Strooom/LoRa-V3-PCB/README.md

# LoRa-V3 PCB




KiCAD design files for the LoRa-V3-PCB.

## Renders
## Front
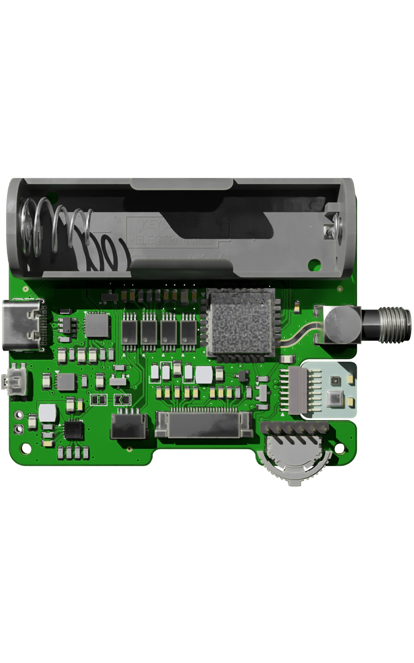
[picture p1: outputs/pcb/front.png]


## Back
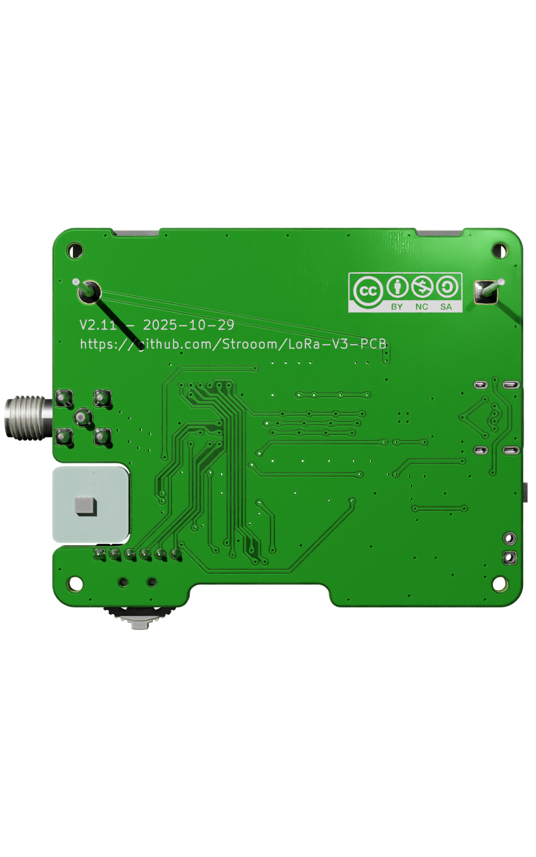
[picture p2: outputs/pcb/back.png]
