Strooom/LoRa-V3-PCB/outputs/reports/PCB design-rule-check report.html

Logo

| DRC report for LoRa-V3-PCB
| PCB: LoRa-V3-PCB Revision: None Date: 2025-10-29T14:37:27+0000 KiCad Version: 8.0.8 | Errors: 0 Warnings: 0 Total: 0

✔

Generated by KiBot (https://github.com/INTI-CMNB/KiBot/) v1.8.5
