Strooom/LoRa-V3-PCB/outputs/reports/schematic electrical-rule-check report.html

Logo

| ERC report for LoRa-V3-PCB
| Schematic: LoRa-V3-PCB Revision: v3.0 Date: 2025-10-29T14:37:25+0000 KiCad Version: 8.0.8 | Errors: 0 Warnings: 0 Total: 0

✔

Generated by KiBot (https://github.com/INTI-CMNB/KiBot/) v1.8.5
