Strooom/LoRa-V3-PCB/inputs/certification/114993121-CE.pdf

# VERIFICATION OF CONFORMITY

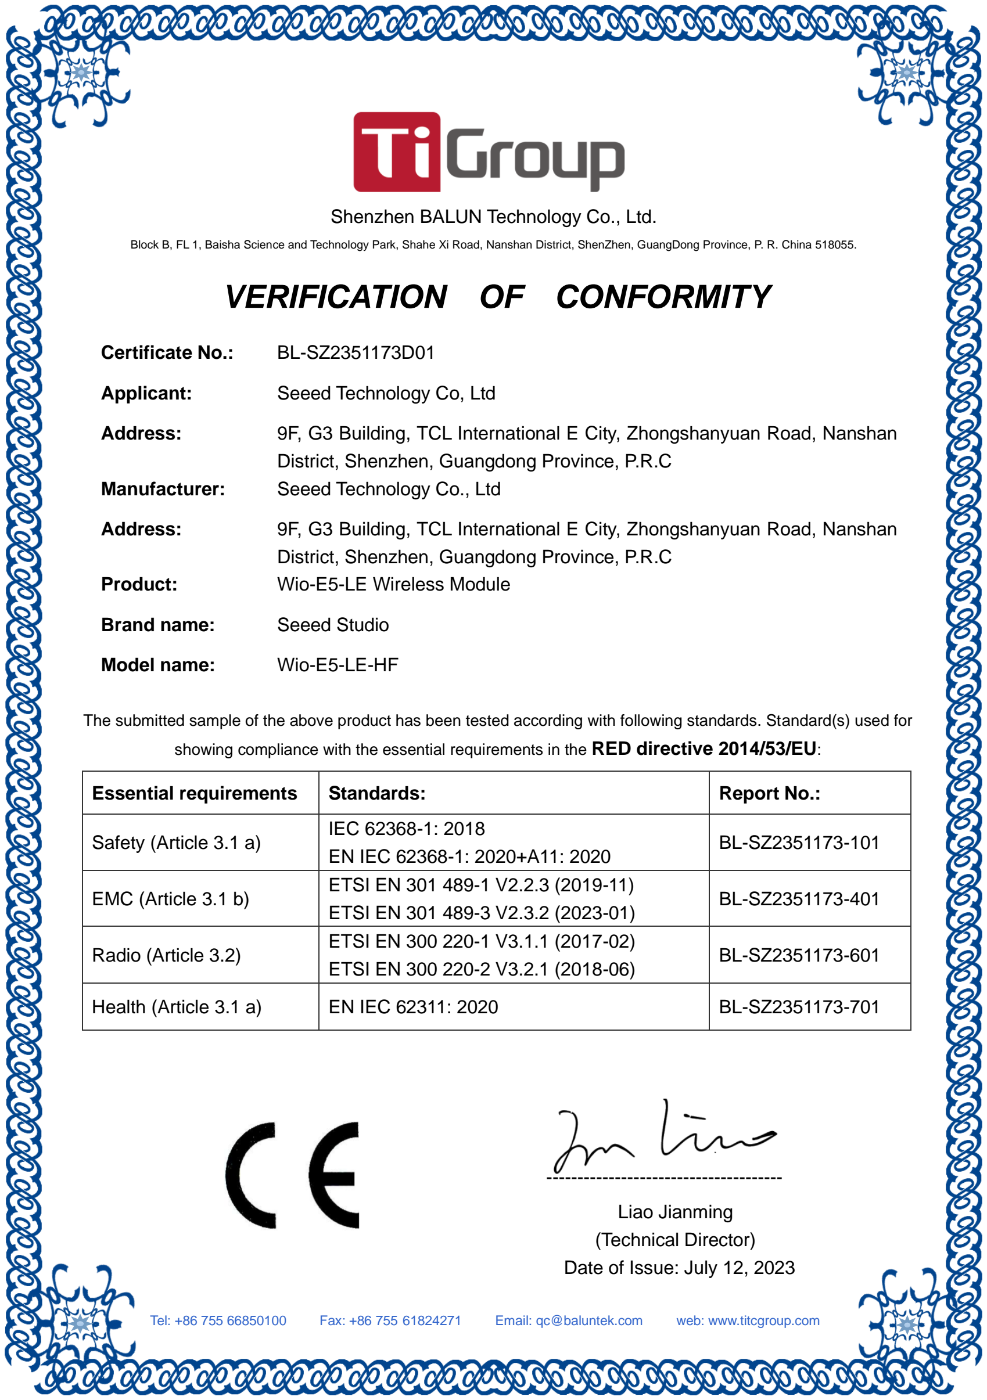
[picture p3: page 1]

Certificate No.: | BL-SZ2351173D01
Applicant: | Seeed Technology Co, Ltd
Address: | 9F, G3 Building, TCL International E City, Zhongshanyuan Road, Nanshan
| District, Shenzhen, Guangdong Province, P.R.C
Manufacturer: | Seeed Technology Co., Ltd
Address: | 9F, G3 Building, TCL International E City, Zhongshanyuan Road, Nanshan
| District, Shenzhen, Guangdong Province, P.R.C
Product: | Wio-E5-LE Wireless Module
Brand name: | Seeed Studio
Model name: | Wio-E5-LE-HF
Essential requirements | Standards: | Report No.:
Safety (Article 3.1 a) | IEC 62368-1: 2018 EN IEC 62368-1: 2020+A11: 2020 | BL-SZ2351173-101
EMC (Article 3.1 b) | ETSI EN 301 489-1 V2.2.3 (2019-11) ETSI EN 301 489-3 V2.3.2 (2023-01) | BL-SZ2351173-401
Radio (Article 3.2) | ETSI EN 300 220-1 V3.1.1 (2017-02) ETSI EN 300 220-2 V3.2.1 (2018-06) | BL-SZ2351173-601
Health (Article 3.1 a) | EN IEC 62311: 2020 | BL-SZ2351173-701

Shenzhen BALUN Technology Co., Ltd.

Block B, FL 1, Baisha Science and Technology Park, Shahe Xi Road, Nanshan District, ShenZhen, GuangDong Province, P. R. China 518055.

The submitted sample of the above product has been tested according with following standards. Standard(s) used for

showing compliance with the essential requirements in the RED directive 2014/53/EU:

Tel: +86 755 66850100 | Fax: +86 755 61824271 | Email: qc@baluntek.com | web: www.titcgroup.com

Liao Jianming
(Technical Director)
Date of Issue: July 12, 2023
