Strooom/LoRa-V3-PCB/inputs/certification/114993121-EUDOC.pdf

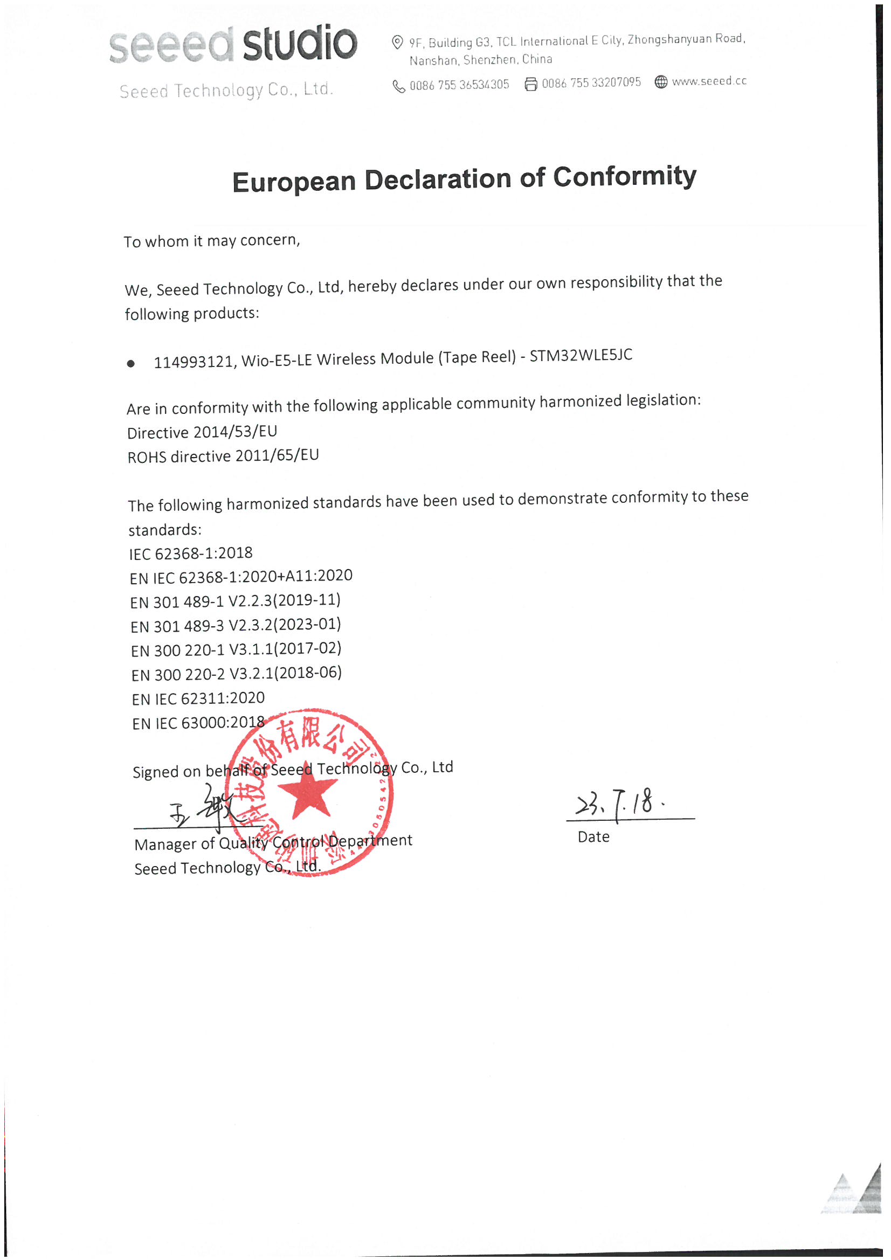
[picture p4: page 1]
