Strooom/LoRa-V3-PCB/inputs/certification/114993121-UKDOC.pdf

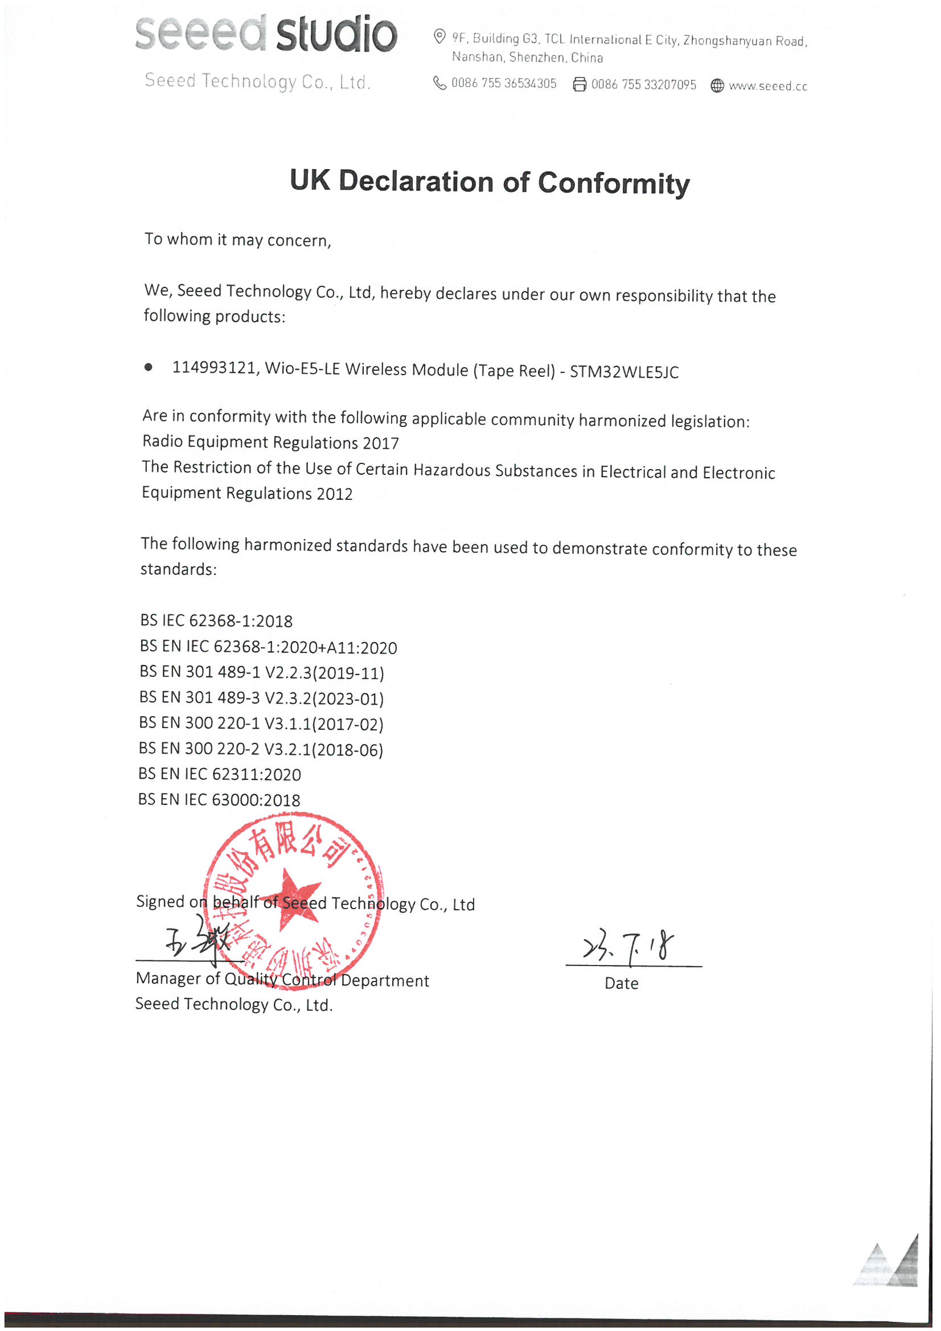
[picture p5: page 1]
