Strooom/LoRa-V3-PCB/outputs/bom/LoRa-V3-PCB-bom.html

 | KiBot Bill of Materials
 | Schematic: LoRa-V3-PCB Variant: default Revision: v3.0 Date: 2024-08-09 KiCad Version: 8.0.8+1 | Component Groups: 35 Component Count: 73 (per PCB) Fitted Components: 73 (per PCB) Number of PCBs: 1 Total Components: 73 (for 1 PCBs)
References | Part | Value | Quantity Per PCB | manufacturerName | manufacturerPartNumber | octopartUrl
C1 C2 C5 C6 C7 C8 C9 C10 | C | 100nF | 8 | TDK | CGA3E2X7R1E104K080AA | https://octopart.com/cga3e2x7r1e104k080aa-tdk-25947977?r=sp
C30 C31 C32 C33 C34 C35 C36 C37 | C_Small | 1uF | 8 | TDK | CGA3E1X7R1E105K080AC | https://octopart.com/cga3e1x7r1e105k080ac-tdk-25947974?r=sp
C11 C12 C13 C14 C15 C16 C17 C18 | C | 4.7uF | 8 | Samsung Electro-Mechanics | CL21B475KPFNFNE | https://octopart.com/cl21b475kpfnfne-samsung+electro-mechanics-24958210
C25 C26 C27 | C | 10uF | 3 | Samsung Electro-Mechanics | CL21B106KPQNNWE | https://octopart.com/cl21b106kpqnnwe-samsung+electro-mechanics-52884428
CONN6 | displayConnector_24p_FPC | 2-1734839-4 | 1 | TE Connectivity | 2-1734839-4 | https://octopart.com/2-1734839-4-te+connectivity-40196932?r=sp
CONN1 | Molex-2171790001 | 217179-0001 | 1 | Molex | 217179-0001 | https://octopart.com/217179-0001-molex-117190526?r=sp
CONN5 | SMA-Antenna-Connector-THT-90 | 73391-0080 | 1 | Molex | 73391-0080 | https://octopart.com/73391-0080-molex-776539?r=sp&pdp=73391-0080-molex-776539¤cy=EUR
CONN2 | LiFePO4_Battery | AA Batteryholder for LiFePO4 battery | 1 | KeyStone | 2460 | https://octopart.com/2460-keystone-17876
CONN3 | Qwiic | SM04B-SRSS-TB(LF)(DN)(P) | 1 | Sparkfun - JST | SM04B-SRSS-TB(LF)(DN)(P) | https://octopart.com/sm04b-srss-tb%28lf%29%28dn%29%28p%29-jst-154671066?r=sp
CONN7 | Conn_01x08_Sensors | Sensors | 1 | GCT | BC075-08-A-L-A
D1 D2 D3 | D | MSS1P3HM3_A/H | 3 | MSS1P3HM3_A/H | MSS1P3HM3_A/H | https://octopart.com/mss1p3hm3_a%2Fh-vishay-71706624?r=sp
IC4 | BQ25504RGTR | BQ25504RGTR | 1 | Texas Instruments | BQ25504RGTR | https://octopart.com/bq25504rgtr-texas+instruments-20530455
IC8 IC9 IC10 IC11 | BR24G1MFVT | BR24G1MFVT-5AE2 | 4 | ROHM | BR24G1MFVT-5AE2 | https://octopart.com/br24g1mfvt-5ae2-rohm-126430213
IC2 | CP2102N-Axx-xQFN24 | CP2102N-Axx-xQFN24 | 1 | Silicon Labs | CP2102N-A02-GQFN24R | https://octopart.com/cp2102n-a02-gqfn24r-silicon+labs-99772192?r=sp
IC12 | MCP73123T | MCP73123T-22SI/MF | 1 | MICROCHIP | MCP73123T-22SI/MF | https://octopart.com/mcp73123t-22si%2Fmf-microchip-17627238?r=sp
IC1 | SeeedStudio_Wio-E5 | SeeedStudio Wio-E5-LE-HF | 1 | Seeed Technology | 114993121 | https://octopart.com/114993121-seeed+studio-142683940
IC3 | USBLC6-2SC6 | USBLC6-2SC6 | 1 | STMicroelectronics | USBLC6-2SC6 | https://octopart.com/usblc6-2sc6-stmicroelectronics-39666276
L2 | L | 22 uH | 1 | TDK | VLS3010CX-220M-1 | https://octopart.com/vls3010cx-220m-1-tdk-108018957?r=sp
L1 | L | 47uH | 1 | TDK | VLS3010CX-470M-1 | https://octopart.com/vls3010cx-470m-1-tdk-110194027?r=sp
Q1 | Q_NMOS_GSD | PJC7400_R1_00001 | 1 | Panjit | PJC7400_R1_00001 | https://octopart.com/pjc7400_r1_00001-panjit-112852220?r=sp
Q2 Q3 Q4 | Si2367DS | Si2367DS | 3 | Vishay Siliconix | SI2367DS-T1-GE3 | https://octopart.com/si2367ds-t1-ge3-vishay-42637886?r=sp
R23 | R | 330 | 1 | YAGEO | RC0603FR-7W330RL | https://octopart.com/rc0603fr-7w330rl-yageo-52751815
R3 | R | 1K | 1 | YAGEO | SR0603JR-071KL | https://octopart.com/sr0603jr-071kl-yageo-71414179
R5 R6 R7 R8 R9 R10 | R | 5K1 | 6 | YAGEO | AC0603DR-075K1L | https://octopart.com/ac0603dr-075k1l-yageo-100620021
R12 | R | 10K | 1 | Bourns | CR0603-JW-103ELF | https://octopart.com/cr0603-fx-1002elf-bourns-2326648?r=sp
R13 | R | 22K1 | 1 | YAGEO | AC0603FR-0722K1L | https://octopart.com/ac0603fr-0722k1l-yageo-30510747
R15 | R | 47K5 | 1 | YAGEO | AC0603FR-0747K5L | https://octopart.com/ac0603fr-0747k5l-yageo-71367307
R17 R18 | R | 330K | 2 | YAGEO | AC0603JR-07330KL | https://octopart.com/ac0603jr-07330kl-yageo-30510863
R2 | R | 1M69 | 1 | YAGEO | RC0603FR-071M69L | https://octopart.com/rc0603fr-071m69l-yageo-16255598
R14 R20 | R | 4M75 | 2 | YAGEO | RC0603FR-074M75L | https://octopart.com/rc0603fr-074m75l-yageo-1187229
R11 R21 | R | 5M36 | 2 | Vishay - Dale | CRCW06035M36FKEA | https://octopart.com/crcw06035m36fkea-vishay-39816157
R19 | R | 8M45 | 1 | YAGEO | RC0603FR-078M45L | https://octopart.com/rc0603fr-078m45l-yageo-26128888
R1 | R | ERJ-3RQJ2R2V | 1 | Panasonic | ERJ-3RQJ2R2V | https://octopart.com/erj3rqj2r2v-panasonic-8095978?r=sp
SW1 | Switch_434331045822 | 434331045822 | 1 | Wurth Electronics | 434331045822 | https://octopart.com/434331045822-wurth+elektronik-22866031?r=sp
SW2 | SLLB510100 | SLLB510100 | 1 | Alps Alpine | SLLB510100 | https://octopart.com/sllb510100-alps-1050713?r=sp
Color reference for columns:
KiCad Fields (default)
Generated Fields
User Fields
Empty Fields
