Strooom/LoRa-V3-PCB/outputs/bom/kicost-bom.xlsx

Prj: | kicost-bom.csv |  |  |  | Board Qty: | 100
Co.: |  |  |  |  | Unit Cost: | €39.49
Prj date: | 2025-03-11 14:44:24 (file) |  |  |  | Total Cost: | €3949.10 |  |  |  |  | €3949.10 | 36 of 37 parts found
$ date: | 2025-03-12 16:26:13
Global Part Info |  |  |  |  |  |  | Mouser
Refs | Value | Footprint | Manf# | Qty | Unit$ | Ext$ | Avail | Purch | Unit$ | MOQ | Ext$ | Cat#
C1-C10 | ??? | ??? | CGA3E2X7R1E104K080AA | 1000 | €0.014 | €14.00 | 928170 |  | €0.014 | 1 | €14.00 | 810-CGA3E2X7R1E104K (https://www.mouser.be/ProductDetail/TDK/CGA3E2X7R1E104K080AA?qs=NRhsANhppD%2Fm7%2FOmmsm0vg%3D%3D)
C11-C18 | ??? | ??? | CL21B475KPFNFNE (https://www.mouser.com/datasheet/2/585/MLCC-1837944.pdf) | 800 | €0.105 | €84.00 | 16674 |  | €0.105 | 1 | €84.00 | 187-CL21B475KPFNFNE (https://www.mouser.be/ProductDetail/Samsung-Electro-Mechanics/CL21B475KPFNFNE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)
C25-C27 | ??? | ??? | CL21B106KPQNNWE (https://www.mouser.com/datasheet/2/585/MLCC-1837944.pdf) | 300 | €0.067 | €20.10 | 260322 |  | €0.067 | 1 | €20.10 | 187-CL21B106KPQNNWE (https://www.mouser.be/ProductDetail/Samsung-Electro-Mechanics/CL21B106KPQNNWE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)
C30-C37 | ??? | ??? | CGA3E1X7R1E105K080AC | 800 | €0.049 | €39.20 | 148338 |  | €0.049 | 1 | €39.20 | 810-CGA3E1X7R1E105K (https://www.mouser.be/ProductDetail/TDK/CGA3E1X7R1E105K080AC?qs=NRhsANhppD9VxGl2AsmRpw%3D%3D)
CONN1 | ??? | ??? | 217179-0001 | 100 | €0.487 | €48.70 | 25716 |  | €0.487 | 1 | €48.70 | 538-217179-0001 (https://www.mouser.be/ProductDetail/Molex/217179-0001?qs=DRkmTr78QAQqCH4BoIR1xg%3D%3D)
CONN2 | ??? | ??? | 1015 (https://www.mouser.com/datasheet/2/215/1015-744831.pdf) | 100 | €1.990 | €199.00 | 21079 |  | €1.990 | 1 | €199.00 | 534-1015 (https://www.mouser.be/ProductDetail/Keystone-Electronics/1015?qs=73q%2FgRcW4F2OhJTPPQWZpA%3D%3D)
CONN3 | ??? | ??? | SM04B-SRSS-TB(LF)(DN)(P) (https://www.mouser.com/datasheet/2/564/eSH-3450197.pdf) | 100 |  |  | NonStk |  |  |  |  | 306-SM04BSRSSTBLFDNP (https://www.mouser.be/ProductDetail/JST-Automotive/SM04B-SRSS-TBLFDNP?qs=HFfMDpzxxd2NueaCTHhRJg%3D%3D)
CONN5 | ??? | ??? | 73391-0080 | 100 | €2.750 | €275.00 | 891 |  | €2.750 | 1 | €275.00 | 538-73391-0080 (https://www.mouser.be/ProductDetail/Molex/73391-0080?qs=Vtbn2VVmZzHv%2FRqBuG7a1A%3D%3D)
CONN6 | ??? | ??? | 2-1734839-4 (https://www.mouser.com/datasheet/2/418/7/ENG_CD_1734839_C_C_1734839-2017341.pdf) | 100 | €0.642 | €64.20 | 133 |  | €0.642 | 1 | €64.20 | 571-2-1734839-4 (https://www.mouser.be/ProductDetail/TE-Connectivity/2-1734839-4?qs=Sm6ibA7evxgHWeCe9t1tOw%3D%3D)
D1-D3 | ??? | ??? | MSS1P3HM3_A/H | 300 | €0.108 | €32.40 | 65583 |  | €0.108 | 1 | €32.40 | 78-MSS1P3HM3_A/H (https://www.mouser.be/ProductDetail/Vishay-General-Semiconductor/MSS1P3HM3_A-H?qs=Pccw3SRxl2RHPUJ7xw8Tvg%3D%3D)
IC1 | ??? | ??? | 114993121 (https://www.mouser.com/datasheet/2/744/Wio_E5_LE_module_datasheet_v1_0-3446934.pdf) | 100 | €7.640 | €764.00 | 96 |  | €7.640 | 1 | €764.00 | 713-114993121 (https://www.mouser.be/ProductDetail/Seeed-Studio/114993121?qs=QpmGXVUTftF1SD6oRXq2Mw%3D%3D)
IC2 | ??? | ??? | CP2102N-A02-GQFN24R (https://www.mouser.com/datasheet/2/368/cp2102n_datasheet-1634912.pdf) | 100 | €2.720 | €272.00 | 12283 |  | €2.720 | 1 | €272.00 | 634-CP2102NA02QFN24R (https://www.mouser.be/ProductDetail/Silicon-Labs/CP2102N-A02-GQFN24R?qs=u16ybLDytRaIVBf0X4zL0g%3D%3D)
IC3 | ??? | ??? | USBLC6-2P6 (https://www.mouser.com/datasheet/2/389/usblc6_2-1852789.pdf) | 100 | €0.192 | €19.20 | 55399 |  | €0.192 | 1 | €19.20 | 511-USBLC6-2P6 (https://www.mouser.be/ProductDetail/STMicroelectronics/USBLC6-2P6?qs=6ARB0lp6jlViGcbUSvj1Mw%3D%3D)
IC4 | ??? | ??? | BQ25504RGTR | 100 | €2.620 | €262.00 | 3093 |  | €2.620 | 1 | €262.00 | 595-BQ25504RGTR (https://www.mouser.be/ProductDetail/Texas-Instruments/BQ25504RGTR?qs=LDM2r2BBpna1ocxRvQkZ2w%3D%3D)
IC5 | ??? | ??? | BME680 (https://www.mouser.com/datasheet/2/783/BST_BME680_DS001-1509608.pdf) | 100 | €5.740 | €574.00 | 8984 |  | €5.740 | 1 | €574.00 | 262-BME680 (https://www.mouser.be/ProductDetail/Bosch-Sensortec/BME680?qs=v271MhAjFHjo0yA%2FC4OnDQ%3D%3D)
IC6 | ??? | ??? | SHT40-BD1B-R2 (https://www.mouser.com/datasheet/2/682/HT_DS_Datasheet_SHT4x_3-2936319.pdf) | 100 | €1.160 | €116.00 | 3188 |  | €1.160 | 1 | €116.00 | 403-SHT40-BD1B-R2 (https://www.mouser.be/ProductDetail/Sensirion/SHT40-BD1B-R2?qs=ulEaXIWI0c%252BjgdkzNQkrGw%3D%3D)
IC7 | ??? | ??? | TSL25911FN (https://www.mouser.com/datasheet/2/588/asset_pdf_25493382-3432823.pdf) | 100 | €1.420 | €142.00 | 8371 |  | €1.420 | 1 | €142.00 | 985-TSL25911FN (https://www.mouser.be/ProductDetail/ams-OSRAM/TSL25911FN?qs=6irNfxKJ9AaiNMbaQmyIug%3D%3D)
IC8-IC11 | ??? | ??? | BR24G1MFVT-5AE2 | 400 | €1.170 | €468.00 | 3347 |  | €1.170 | 1 | €468.00 | 755-BR24G1MFVT-5AE2 (https://www.mouser.be/ProductDetail/ROHM-Semiconductor/BR24G1MFVT-5AE2?qs=MyNHzdoqoQKnzx5taP2O%252BA%3D%3D)
IC12 | ??? | ??? | MCP73123T-22SI/MF (https://www.mouser.com/datasheet/2/268/22191E-3443442.pdf) | 100 | €1.080 | €108.00 | 1245 |  | €1.080 | 1 | €108.00 | 579-MCP73123T-22SIMF (https://www.mouser.be/ProductDetail/Microchip-Technology/MCP73123T-22SI-MF?qs=E6wAi2XWqcPyISItqwXTaQ%3D%3D)
L1 | ??? | ??? | VLS3010CX-470M-1 | 100 | €0.112 | €11.20 | 3674 |  | €0.112 | 1 | €11.20 | 810-VLS3010CX470M1 (https://www.mouser.be/ProductDetail/TDK/VLS3010CX-470M-1?qs=sPbYRqrBIVklbjNBYl28FA%3D%3D)
L2 | ??? | ??? | VLS3010CX-220M-1 | 100 | €0.150 | €15.00 | 2404 |  | €0.150 | 1 | €15.00 | 810-VLS3010CX220M1 (https://www.mouser.be/ProductDetail/TDK/VLS3010CX-220M-1?qs=sPbYRqrBIVnZdOaBHPV0MQ%3D%3D)
Q1 | ??? | ??? | PJC7400_R1_00001 (https://www.mouser.com/datasheet/2/1057/PJC7400-1868968.pdf) | 100 | €0.072 | €7.20 | 34967 |  | €0.072 | 1 | €7.20 | 241-PJC7400_R1_00001 (https://www.mouser.be/ProductDetail/Panjit/PJC7400_R1_00001?qs=sPbYRqrBIVlqNtfR5hXF4A%3D%3D)
Q2-Q4 | ??? | ??? | SI2367DS-T1-GE3 | 300 | €0.245 | €73.50 | 5668 |  | €0.245 | 1 | €73.50 | 781-SI2367DS-GE3 (https://www.mouser.be/ProductDetail/Vishay-Semiconductors/SI2367DS-T1-GE3?qs=kt16UJ73eEHbeglRjuryig%3D%3D)
R1 | ??? | ??? | ERJ-3RQJ2R2V | 100 | €0.029 | €2.90 | 17203 |  | €0.029 | 1 | €2.90 | 667-ERJ-3RQJ2R2V (https://www.mouser.be/ProductDetail/Panasonic/ERJ-3RQJ2R2V?qs=Ytx7DkVehETJPMlDNlXENw%3D%3D)
R2 | ??? | ??? | RC0603FR-071M69L (https://www.mouser.com/datasheet/2/447/PYu_RC_Group_51_RoHS_L_12-3368608.pdf) | 100 | €0.009 | €0.90 | 174195 |  | €0.009 | 1 | €0.90 | 603-RC0603FR-071M69L (https://www.mouser.be/ProductDetail/YAGEO/RC0603FR-071M69L?qs=0yPvnVz5%2Fmqj6bp9FXiCew%3D%3D)
R3 | ??? | ??? | SR0603JR-071KL (https://www.mouser.com/datasheet/2/447/YAGEO_11022023_PYu_SR_20105_RoHS_L_11-3361774.pdf) | 100 | €0.038 | €3.80 | 150380 |  | €0.038 | 1 | €3.80 | 603-SR0603JR-071KL (https://www.mouser.be/ProductDetail/YAGEO/SR0603JR-071KL?qs=TyBUSTk9pD97MoKjQ9xH4g%3D%3D)
R5-R10 | ??? | ??? | AC0603DR-075K1L (https://www.mouser.com/datasheet/2/447/PYu_AC_51_RoHS_L_11-3418659.pdf) | 600 | €0.016 | €9.60 | 60096 |  | €0.016 | 1 | €9.60 | 603-AC0603DR-075K1L (https://www.mouser.be/ProductDetail/YAGEO/AC0603DR-075K1L?qs=fTsMJN6MUUuGibmKEEUTpQ%3D%3D)
R11,R21 | ??? | ??? | RC0603FR-075M36L (https://www.mouser.com/datasheet/2/447/PYu_RC_Group_51_RoHS_L_11-1984063.pdf) | 200 | €0.010 | €2.00 | NonStk |  | €0.010 | 1 | €2.00 | 603-RC0603FR-075M36L (https://www.mouser.be/ProductDetail/YAGEO/RC0603FR-075M36L?qs=EiqXWrxQq61wtU12vahNbg%3D%3D)
R12 | ??? | ??? | CR0603-JW-103ELF (https://www.mouser.com/datasheet/2/54/cr-1858361.pdf) | 100 | €0.007 | €0.70 | 457126 |  | €0.007 | 1 | €0.70 | 652-CR0603-JW-103ELF (https://www.mouser.be/ProductDetail/Bourns/CR0603-JW-103ELF?qs=tprK%2FdUq6q6vORSl%252Bpo4rg%3D%3D)
R13 | ??? | ??? | AC0603FR-0722K1L (https://www.mouser.com/datasheet/2/447/PYu_AC_51_RoHS_L_11-3418659.pdf) | 100 | €0.009 | €0.90 | 355233 |  | €0.009 | 1 | €0.90 | 603-AC0603FR-0722K1L (https://www.mouser.be/ProductDetail/YAGEO/AC0603FR-0722K1L?qs=ygRr%2FtkhtetDZXS2sa3i2w%3D%3D)
R14,R20 | ??? | ??? | RC0603FR-074M75L (https://www.mouser.com/datasheet/2/447/YAGEO_PYu_RC_Group_51_RoHS_L_12-3313492.pdf) | 200 | €0.007 | €1.40 | 44745 |  | €0.007 | 1 | €1.40 | 603-RC0603FR-074M75L (https://www.mouser.be/ProductDetail/YAGEO/RC0603FR-074M75L?qs=KuCtQF8z8nCEE2Ng4Op1ag%3D%3D)
R15 | ??? | ??? | AC0603FR-0747K5L (https://www.mouser.com/datasheet/2/447/PYu_AC_51_RoHS_L_11-3418659.pdf) | 100 | €0.009 | €0.90 | 19285 |  | €0.009 | 1 | €0.90 | 603-AC0603FR-0747K5L (https://www.mouser.be/ProductDetail/YAGEO/AC0603FR-0747K5L?qs=ygRr%2Ftkhtes%2F5uKM6MtQGw%3D%3D)
R17,R18 | ??? | ??? | AC0603JR-07330KL (https://www.mouser.com/datasheet/2/447/PYu_AC_51_RoHS_L_11-3418659.pdf) | 200 | €0.007 | €1.40 | 64642 |  | €0.007 | 1 | €1.40 | 603-AC0603JR-07330KL (https://www.mouser.be/ProductDetail/YAGEO/AC0603JR-07330KL?qs=ygRr%2FtkhteswRX2BvSPS%2Fg%3D%3D)
R19 | ??? | ??? | RC0603FR-078M45L (https://www.mouser.com/datasheet/2/447/PYu_RC_Group_51_RoHS_L_11-1984063.pdf) | 100 | €0.010 | €1.00 | 31341 |  | €0.010 | 1 | €1.00 | 603-RC0603FR-078M45L (https://www.mouser.be/ProductDetail/YAGEO/RC0603FR-078M45L?qs=EiqXWrxQq61D3M9nCx1jvA%3D%3D)
R23 | ??? | ??? | RC0603FR-7W330RL (https://www.mouser.com/datasheet/2/447/PYu_RC_Group_51_RoHS_L_12-3368608.pdf) | 100 | €0.013 | €1.30 | 31569 |  | €0.013 | 1 | €1.30 | 603-RC0603FR-7W330RL (https://www.mouser.be/ProductDetail/YAGEO/RC0603FR-7W330RL?qs=tggtontpCXPwS4JfrCYUrA%3D%3D)
SW1 | ??? | ??? | 434331045822 | 100 | €0.466 | €46.60 | 5561 |  | €0.466 | 1 | €46.60 | 710-434331045822 (https://www.mouser.be/ProductDetail/Wurth-Elektronik/434331045822?qs=wr8lucFkNMXGC%252BBo3q5pkg%3D%3D)
SW2 | ??? | ??? | SLLB510100 (https://www.mouser.com/datasheet/2/15/SLLB5-1570014.pdf) | 100 | €2.670 | €267.00 | 5078 |  | €2.670 | 1 | €267.00 | 688-SLLB510100 (https://www.mouser.be/ProductDetail/Alps-Alpine/SLLB510100?qs=m0BA540hBPceO6mn4aSKcg%3D%3D)
 |  |  |  |  | Total Purchase: | €0.00 | Buy here (https://mouser.com/bom/) |  |  |  | €0.00
KiCost® v1.1.19 |  |  |  |  | Purchase description:
