Strooom/LoRa-V3-PCB/inputs/3dmodels/2460.step

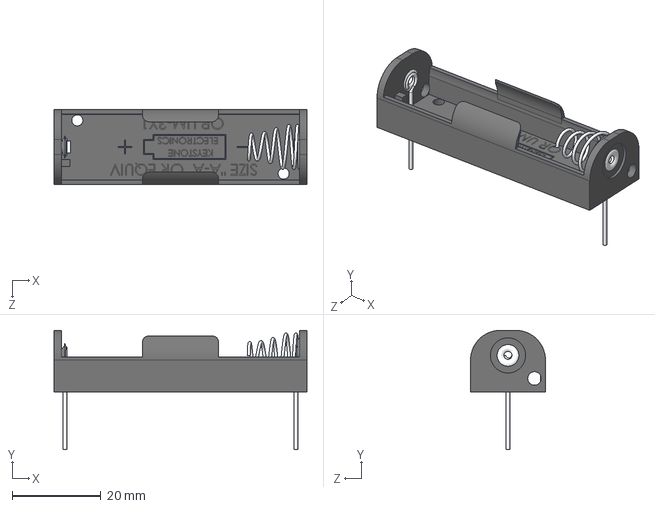
[picture p6: CAD file, 2025-08-07]
inputs/3dmodels/2460.step
57.0 x 26.9 x 16.9 mm
