Strooom/LoRa-V3-PCB/projectlibraries/1project3dmodels/1015.stp

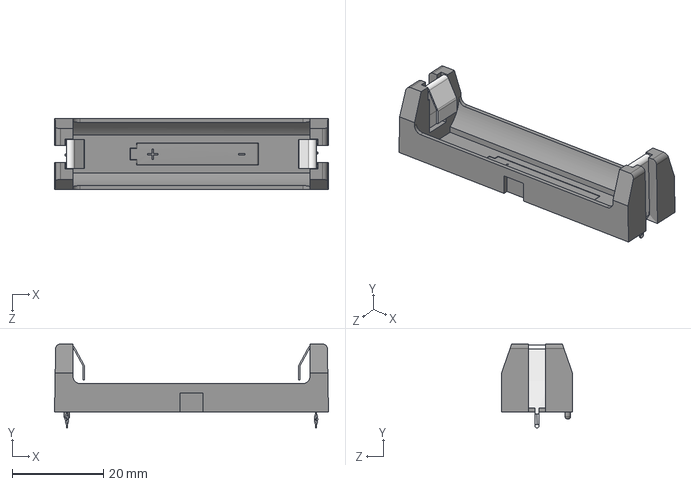
[picture p7: CAD file, 2024-09-23]
projectlibraries/1project3dmodels/1015.stp
59.9 x 18.3 x 15.5 mm
