Strooom/LoRa-V3-PCB/projectlibraries/inputs/DFN-8 2x3.step

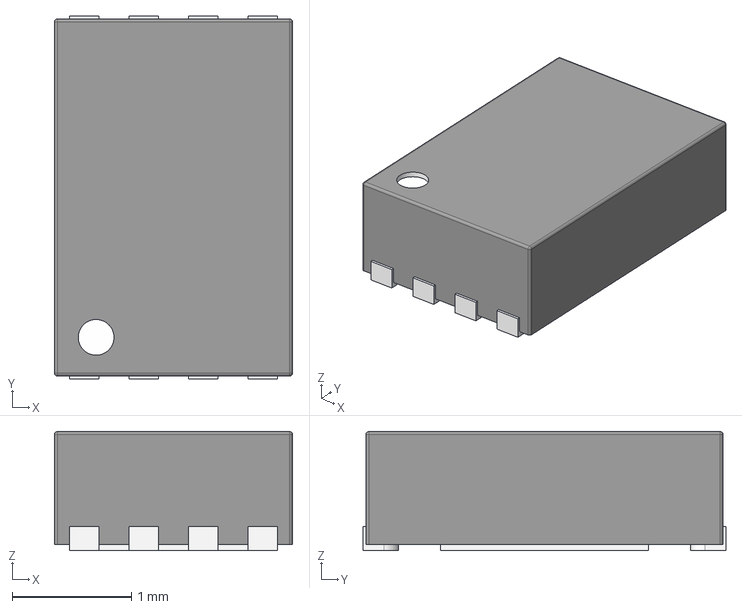
[picture p8: CAD file, 2024-09-23]
projectlibraries/inputs/DFN-8 2x3.step
2.00 x 3.05 x 1.00 mm
