Strooom/LoRa-V3-PCB/inputs/3dmodels/LoRa-V3-Sensor-PCB-3D.step

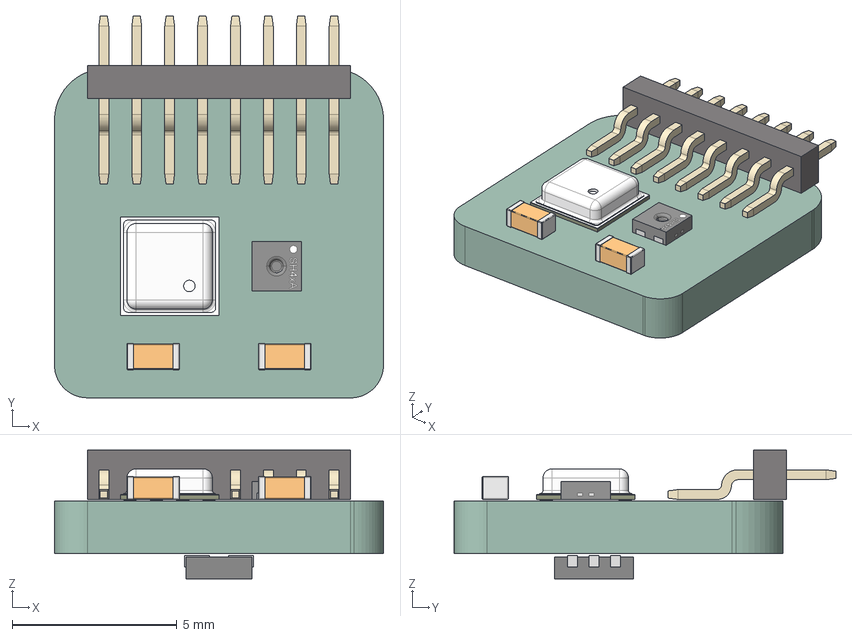
[picture p9: CAD file, 2025-04-23]
inputs/3dmodels/LoRa-V3-Sensor-PCB-3D.step
10.0 x 11.6 x 3.91 mm
BC034-08-A-V-0150-L-C
BME680
149048-00_Publikationsmodell SHT4xA-StandardDFN
LoRa-V3-Sensor-PCB_PCB
