Strooom/LoRa-V3-PCB/projectlibraries/1project3dmodels/PCB.SMAFRA.HT.stp

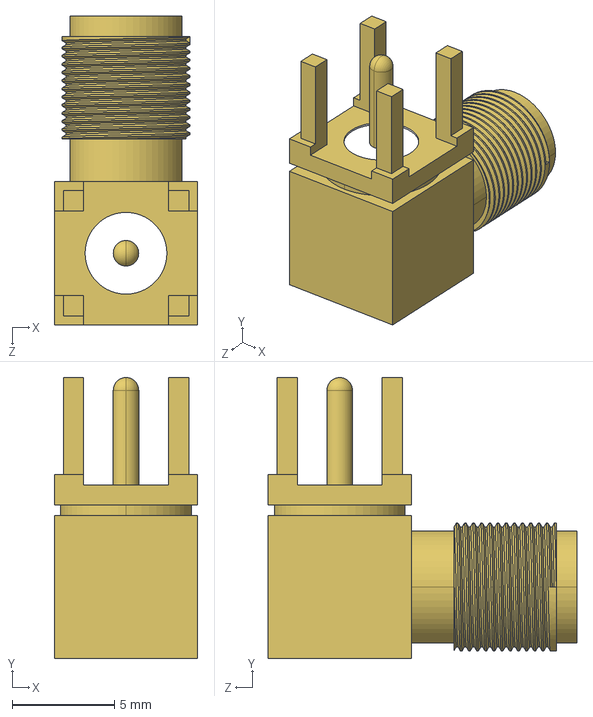
[picture p10: CAD file, 2024-09-23]
projectlibraries/1project3dmodels/PCB.SMAFRA.HT.stp
7.00 x 13.8 x 15.1 mm
