Strooom/LoRa-V3-PCB/projectlibraries/inputs/SDM05U40CSPQ-7.stp

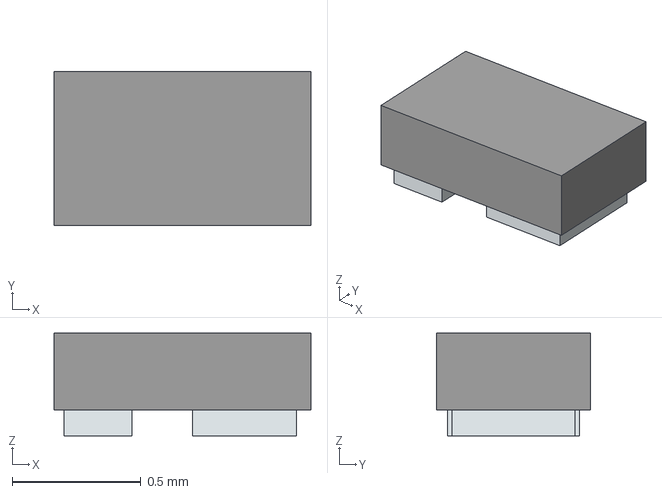
[picture p11: CAD file, 2024-09-23]
projectlibraries/inputs/SDM05U40CSPQ-7.stp
1.00 x 0.6 x 0.4 mm
Pins
