Strooom/LoRa-V3-PCB/inputs/3dmodels/BC075-08-A-L-A.stp

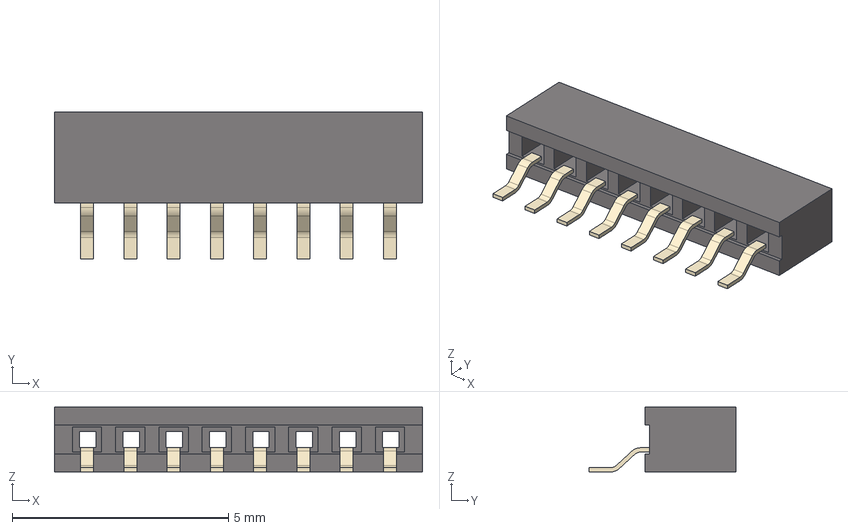
[picture p12: CAD file, 2025-04-16]
inputs/3dmodels/BC075-08-A-L-A.stp
8.50 x 3.40 x 1.50 mm
BC075-08-A-L-A_H
BC075-08-A-L-A_P x 8
