Strooom/LoRa-V3-PCB/projectlibraries/inputs/SPV1050-WST.stp

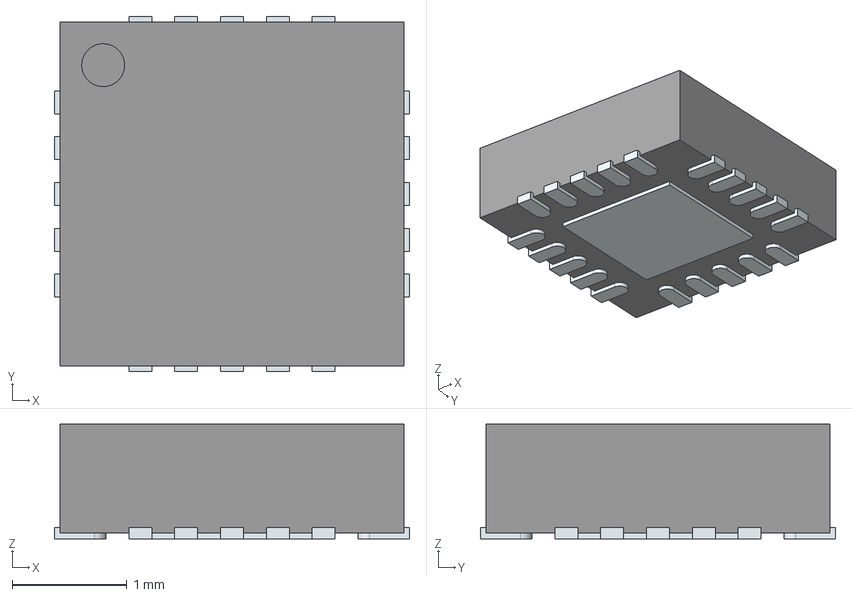
[picture p13: CAD file, 2024-09-23]
projectlibraries/inputs/SPV1050-WST.stp
3.10 x 3.10 x 1.00 mm
ThermalPin
PinsArrayLR
PinsArrayTB
