Strooom/LoRa-V3-PCB/inputs/3dmodels/BC034-04-A-V-0150-L-C.STEP

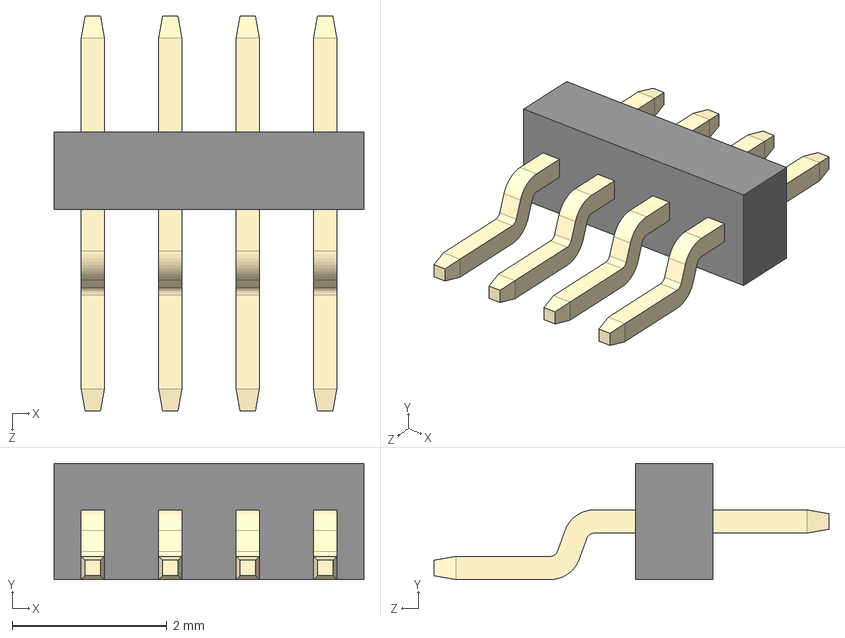
[picture p14: CAD file, 2025-03-12]
inputs/3dmodels/BC034-04-A-V-0150-L-C.STEP
4.00 x 1.50 x 5.10 mm
body^BC034-xxxxx
pin^BC034-xxxxx x 4
