Strooom/LoRa-V3-PCB/projectlibraries/inputs/VLS3010CX-470M-1.stp

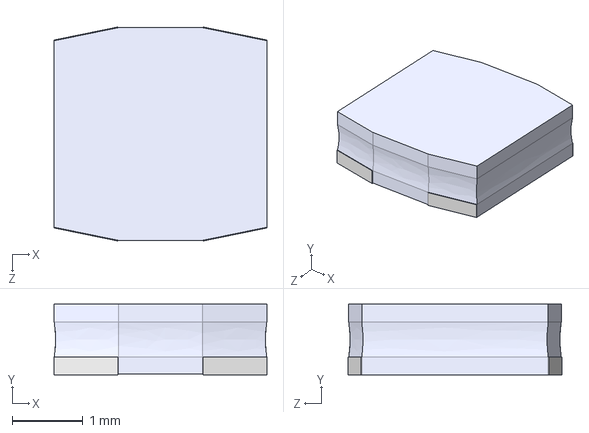
[picture p15: CAD file, 2024-09-23]
projectlibraries/inputs/VLS3010CX-470M-1.stp
3.00 x 1.00 x 3.02 mm
