Strooom/LoRa-V3-PCB/inputs/3dmodels/BC075-04-A-L-A.stp

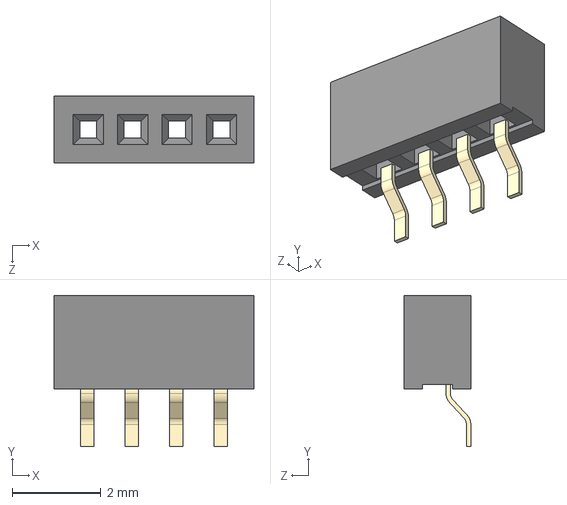
[picture p16: CAD file, 2025-03-12]
inputs/3dmodels/BC075-04-A-L-A.stp
4.50 x 3.40 x 1.50 mm
