Strooom/LoRa-V3-PCB/projectlibraries/inputs/SPARKFUN_QWIIC_RIGHT_ANGLE.step

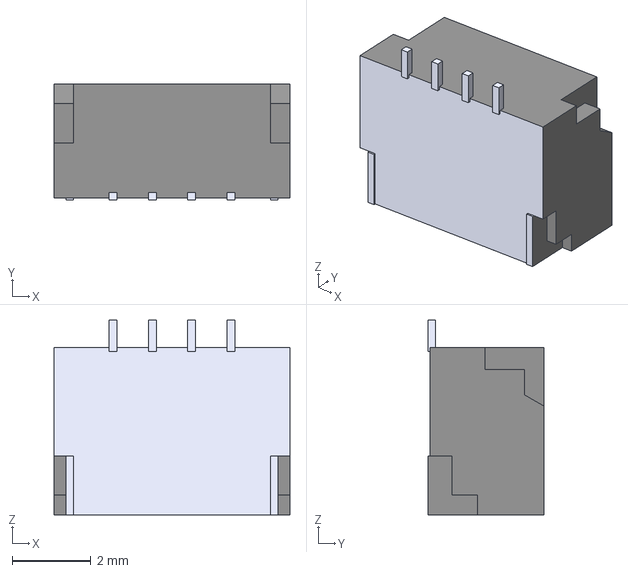
[picture p17: CAD file, 2024-09-23]
projectlibraries/inputs/SPARKFUN_QWIIC_RIGHT_ANGLE.step
6.00 x 2.96 x 4.95 mm
