Strooom/LoRa-V3-PCB/inputs/3dmodels/QFN-16 (3x3).stp

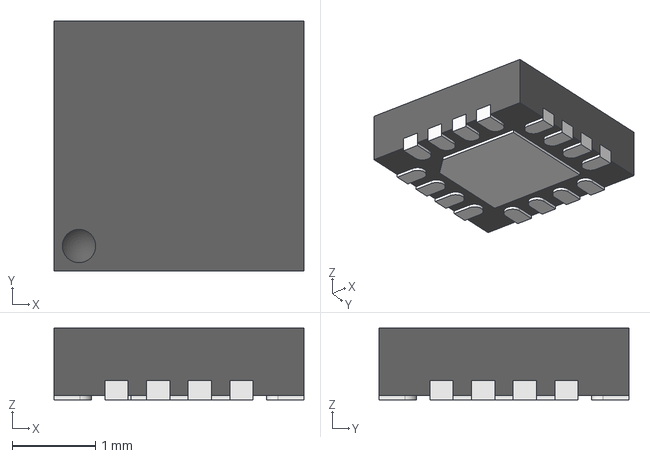
[picture p18: CAD file, 2025-03-11]
inputs/3dmodels/QFN-16 (3x3).stp
3.00 x 3.00 x 0.86 mm
QFN-16 (3x3) Part1
QFN-16 (3x3) Part2 x 16
