Strooom/LoRa-V3-PCB/projectlibraries/inputs/keystone-PN1024.STEP

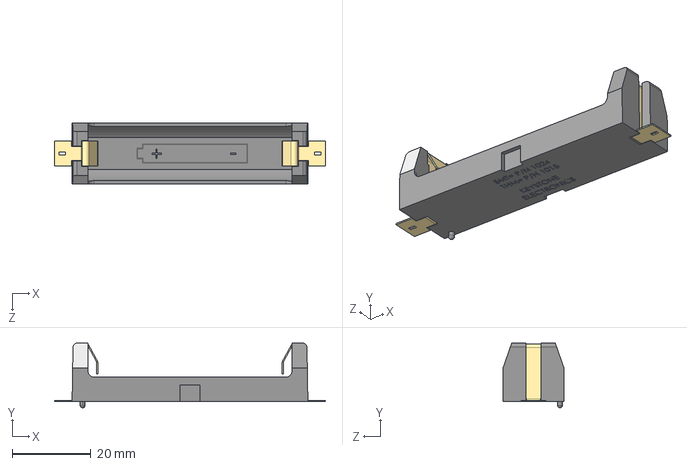
[picture p19: CAD file, 2024-09-23]
projectlibraries/inputs/keystone-PN1024.STEP
68.9 x 16.4 x 15.5 mm
