Strooom/LoRa-V3-PCB/inputs/3dmodels/C0805.stp

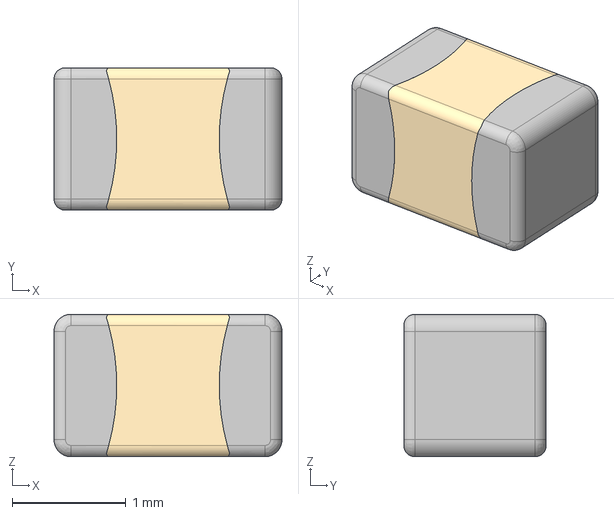
[picture p20: CAD file, 2025-03-11]
inputs/3dmodels/C0805.stp
2.00 x 1.25 x 1.25 mm
