Strooom/LoRa-V3-PCB/projectlibraries/inputs/USBLC6-2P6.stp

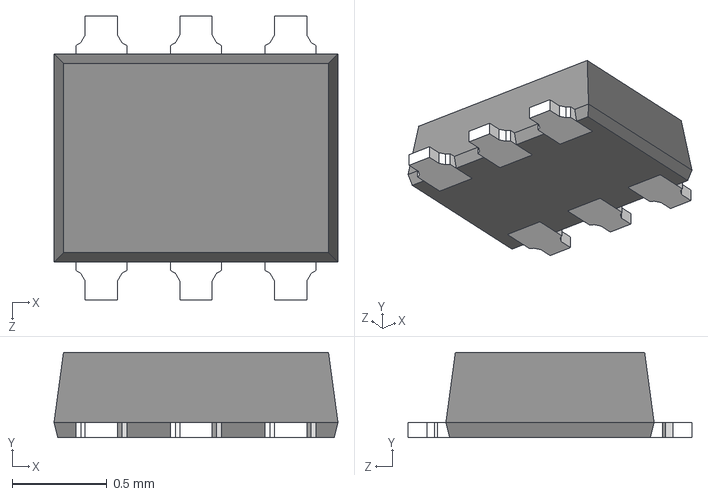
[picture p21: CAD file, 2024-09-23]
projectlibraries/inputs/USBLC6-2P6.stp
1.50 x 0.45 x 1.50 mm
