Strooom/LoRa-V3-PCB/inputs/3dmodels/wurth-434331045822.stp

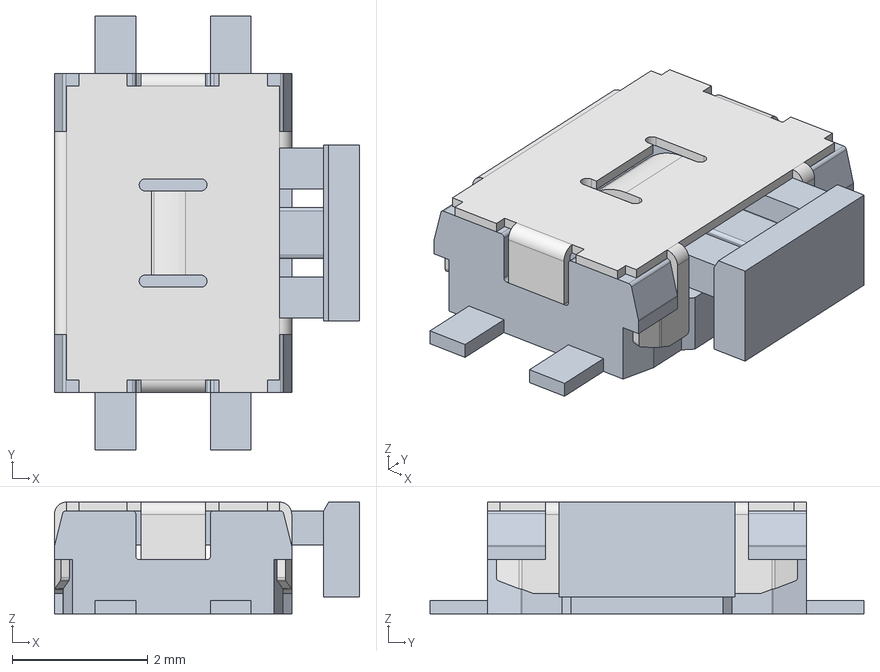
[picture p22: CAD file, 2025-02-06]
inputs/3dmodels/wurth-434331045822.stp
4.50 x 6.40 x 1.65 mm
