Strooom/LoRa-V3-PCB/projectlibraries/inputs/VEML7700.stp

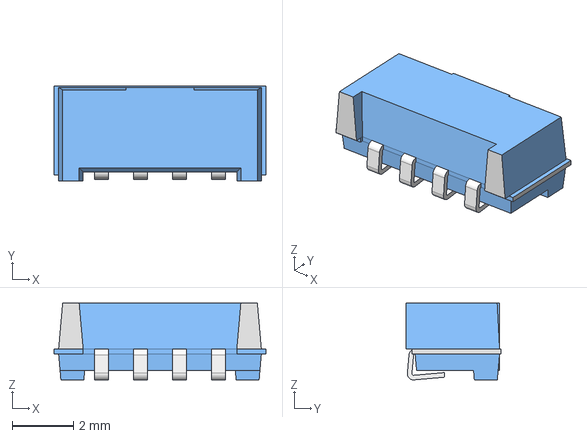
[picture p23: CAD file, 2024-09-23]
projectlibraries/inputs/VEML7700.stp
6.90 x 3.10 x 2.50 mm
