Strooom/LoRa-V3-PCB/inputs/3dmodels/SLLB510100.STEP

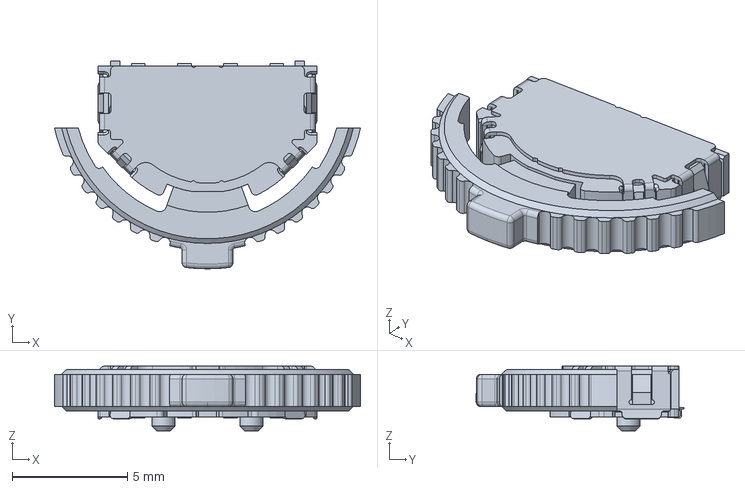
[picture p24: CAD file, 2025-02-06]
inputs/3dmodels/SLLB510100.STEP
13.3 x 9.00 x 2.80 mm
