Strooom/LoRa-V3-PCB/projectlibraries/inputs/SP0503BAHTG.step

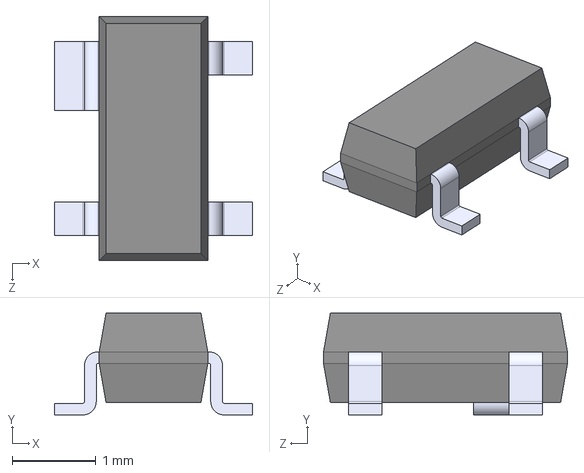
[picture p25: CAD file, 2024-09-23]
projectlibraries/inputs/SP0503BAHTG.step
2.37 x 1.22 x 2.92 mm
