Strooom/LoRa-V3-PCB/inputs/3dmodels/TSSOP8.STEP

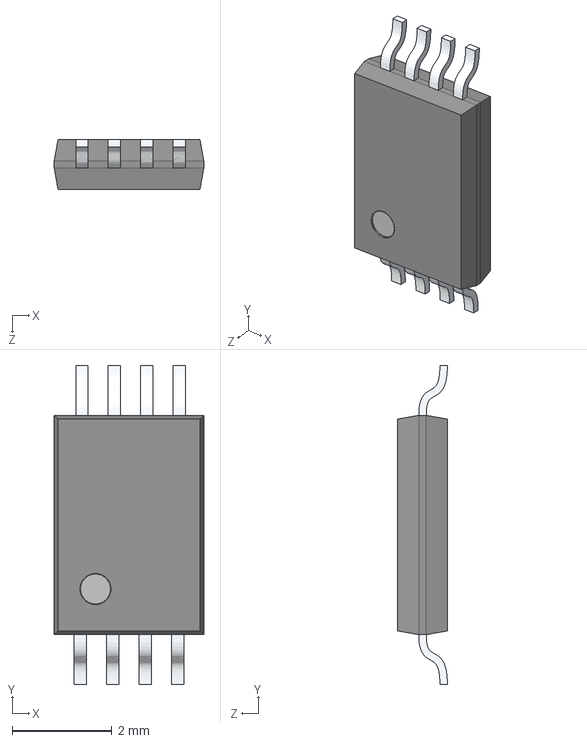
[picture p26: CAD file, 2025-02-06]
inputs/3dmodels/TSSOP8.STEP
3.00 x 6.40 x 1.00 mm
