Strooom/LoRa-V3-PCB/inputs/3dmodels/SOT23.STEP

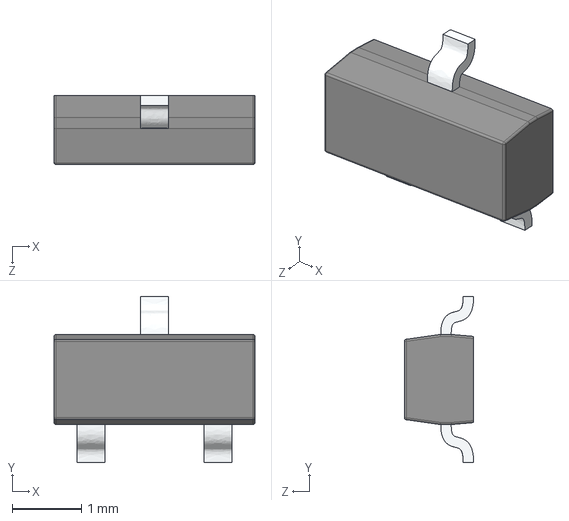
[picture p27: CAD file, 2025-02-06]
inputs/3dmodels/SOT23.STEP
2.90 x 2.40 x 1.00 mm
