Strooom/LoRa-V3-PCB/projectlibraries/inputs/CONSMA020.062-G--3DModel-STEP-269445.STEP

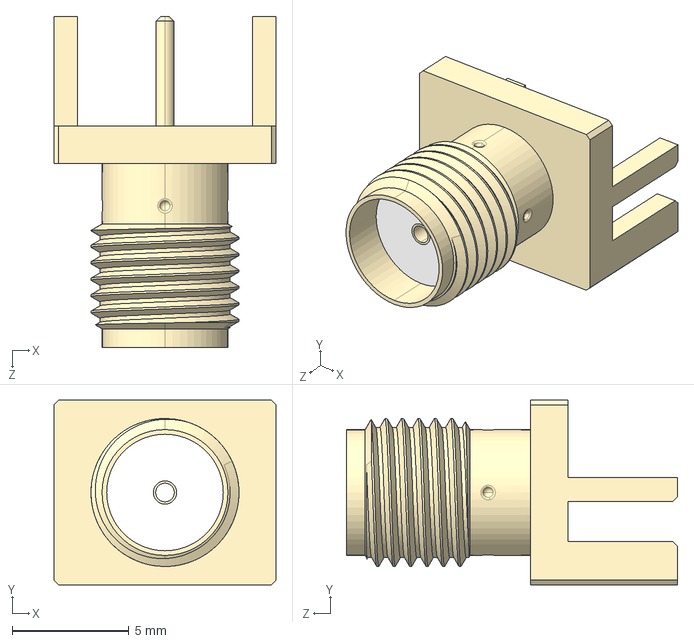
[picture p28: CAD file, 2024-09-23]
projectlibraries/inputs/CONSMA020.062-G--3DModel-STEP-269445.STEP
9.52 x 7.92 x 14.2 mm
