Strooom/LoRa-V3-PCB/inputs/3dmodels/R0603.step

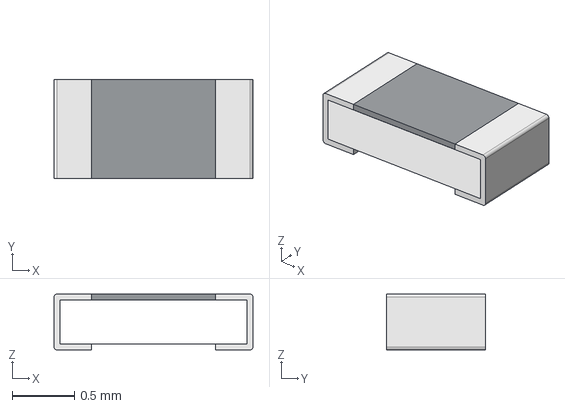
[picture p29: CAD file, 2024-10-10]
inputs/3dmodels/R0603.step
1.60 x 0.8 x 0.45 mm
