Strooom/LoRa-V3-PCB/projectlibraries/inputs/SSCM110100.STEP

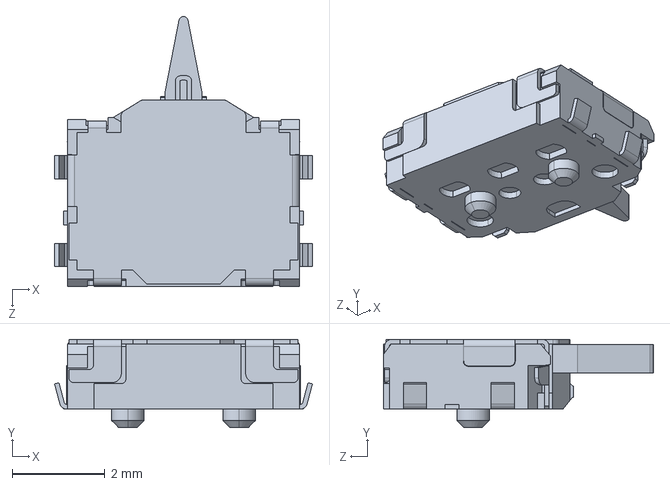
[picture p30: CAD file, 2024-09-23]
projectlibraries/inputs/SSCM110100.STEP
5.56 x 1.90 x 5.82 mm
