Strooom/LoRa-V3-PCB/inputs/3dmodels/C0603.step

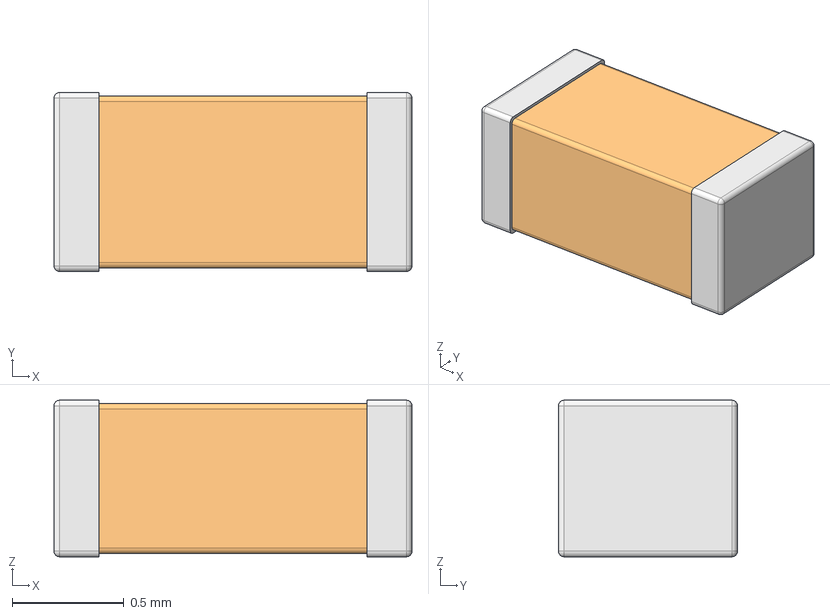
[picture p31: CAD file, 2024-10-10]
inputs/3dmodels/C0603.step
1.60 x 0.8 x 0.7 mm
