Strooom/LoRa-V3-PCB/projectlibraries/inputs/vls6045ex.step

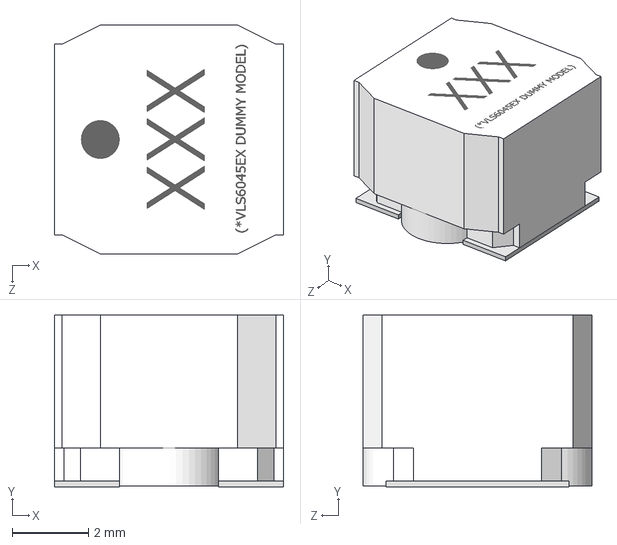
[picture p32: CAD file, 2024-09-23]
projectlibraries/inputs/vls6045ex.step
6.00 x 4.50 x 6.00 mm
VLS6045EX_C(3Dmodel)
VLS6045EX_T(3Dmodel)
