Strooom/LoRa-V3-PCB/inputs/3dmodels/SHT40-AD1B-R2.step

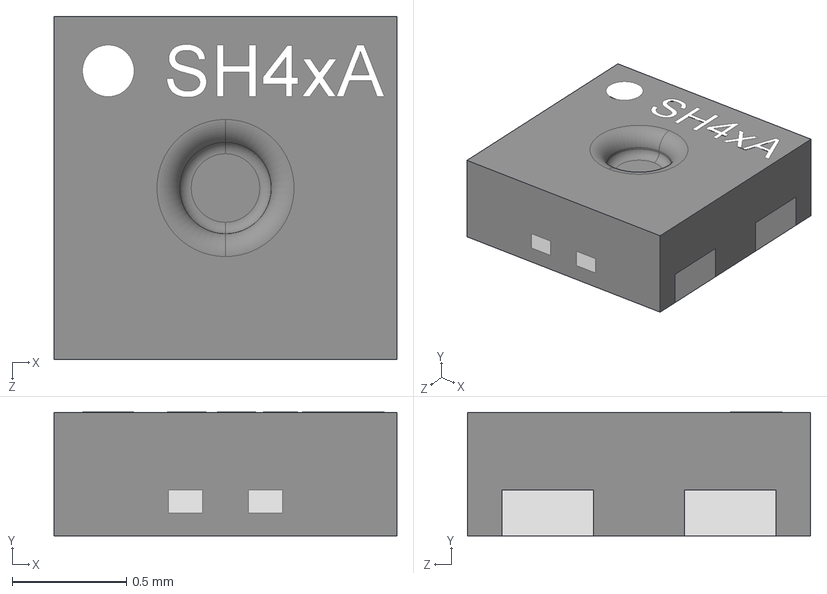
[picture p33: CAD file, 2024-09-23]
inputs/3dmodels/SHT40-AD1B-R2.step
1.50 x 0.541 x 1.50 mm
