Strooom/LoRa-V3-PCB/projectlibraries/inputs/BME680.step

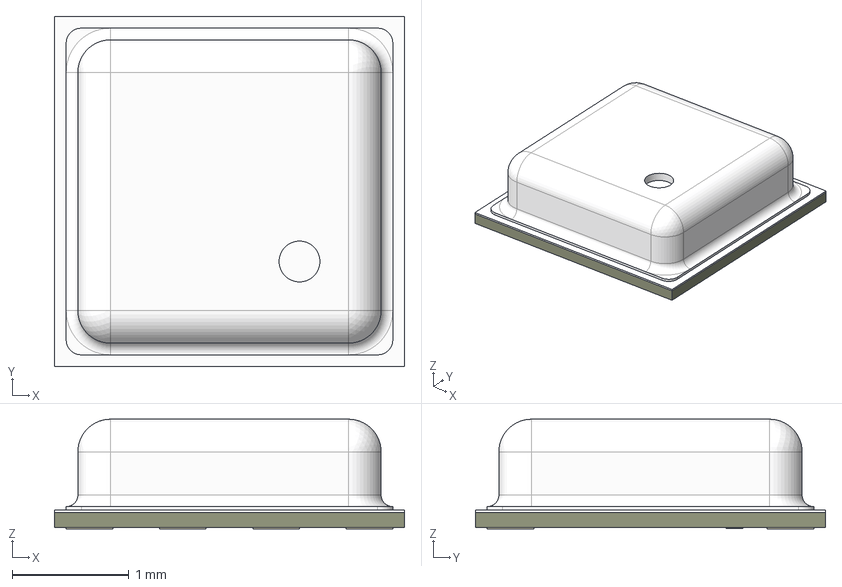
[picture p34: CAD file, 2024-09-23]
projectlibraries/inputs/BME680.step
3.00 x 3.00 x 0.94 mm
pads
pcb
lid
