Strooom/LoRa-V3-PCB/inputs/3dmodels/MSMP package.STEP

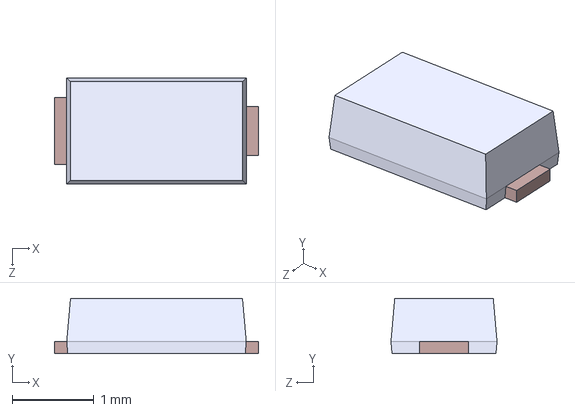
[picture p35: CAD file, 2024-09-23]
inputs/3dmodels/MSMP package.STEP
2.50 x 0.68 x 1.30 mm
