Strooom/LoRa-V3-PCB/projectlibraries/inputs/SOT95P285X140-5N.step

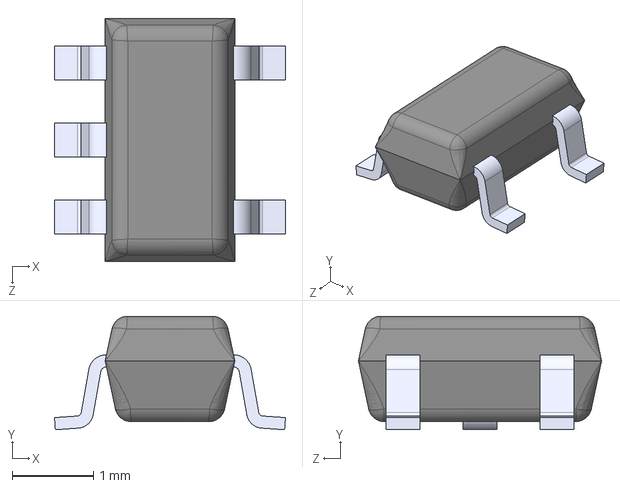
[picture p36: CAD file, 2024-09-23]
projectlibraries/inputs/SOT95P285X140-5N.step
2.85 x 1.40 x 3.00 mm
