Strooom/LoRa-V3-PCB/inputs/3dmodels/QFN24-4X4.STEP

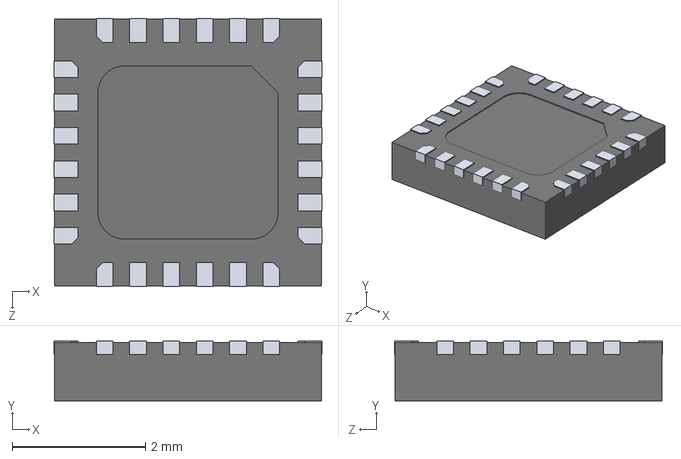
[picture p37: CAD file, 2024-09-23]
inputs/3dmodels/QFN24-4X4.STEP
4.02 x 0.9 x 4.02 mm
