Strooom/LoRa-V3-PCB/projectlibraries/inputs/c-2016504-1-a-3d.stp

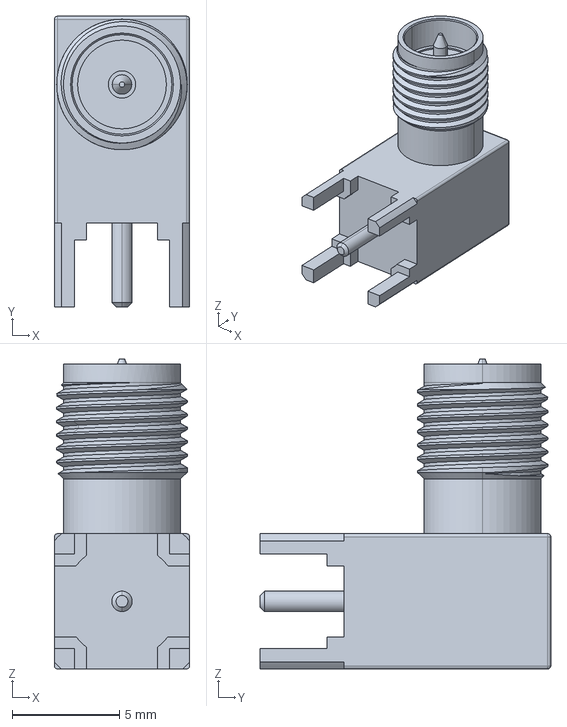
[picture p38: CAD file, 2024-09-23]
projectlibraries/inputs/c-2016504-1-a-3d.stp
6.30 x 13.5 x 14.4 mm
