Strooom/LoRa-V3-PCB/inputs/3dmodels/SON-06-FN_2000X2400_AMS.step

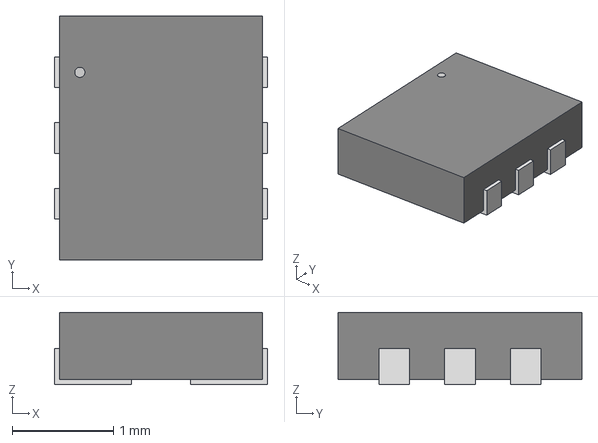
[picture p39: CAD file, 2024-09-23]
inputs/3dmodels/SON-06-FN_2000X2400_AMS.step
2.11 x 2.41 x 0.714 mm
