Strooom/LoRa-V3-PCB/projectlibraries/inputs/VLS4012CX-220M-1.stp

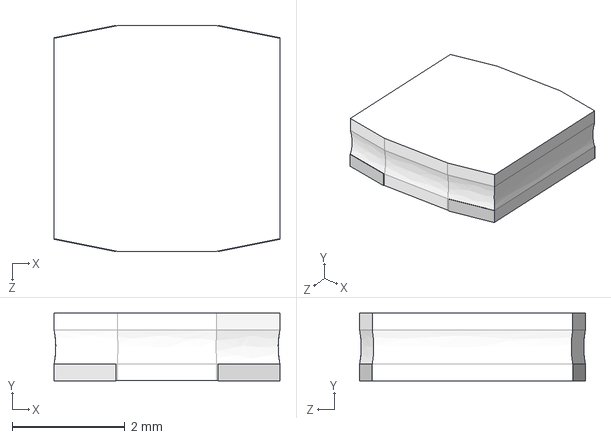
[picture p40: CAD file, 2024-09-23]
projectlibraries/inputs/VLS4012CX-220M-1.stp
4.00 x 1.20 x 4.01 mm
