Strooom/LoRa-V3-PCB/inputs/3dmodels/LoRa-E5-HF_3D_File.stp

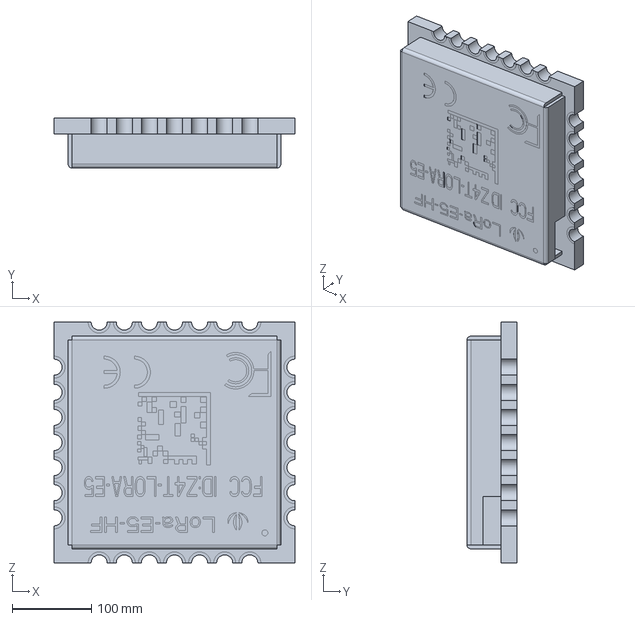
[picture p41: CAD file, 2024-09-23]
inputs/3dmodels/LoRa-E5-HF_3D_File.stp
304.8 x 63.8 x 304.8 mm
