Strooom/LoRa-V3-PCB/projectlibraries/inputs/PTS815SJM250SMTRLFS.stp

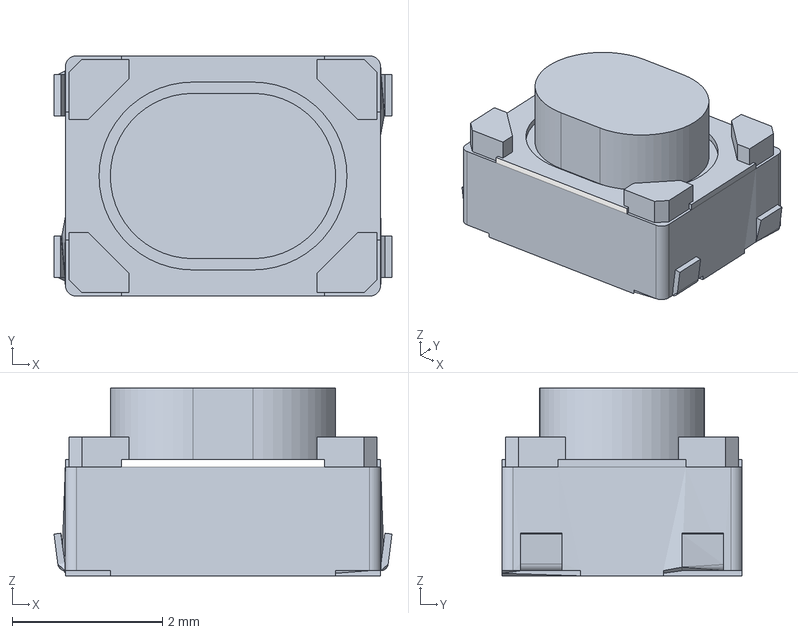
[picture p42: CAD file, 2024-09-23]
projectlibraries/inputs/PTS815SJM250SMTRLFS.stp
4.50 x 3.20 x 2.50 mm
PTS815SJM250SMTRLFS_PART3
PTS815SJM250SMTRLFS_PART2
PTS815SJM250SMTRLFS_PART1
