Strooom/LoRa-V3-PCB/projectlibraries/inputs/STHS34PF80TR.stp

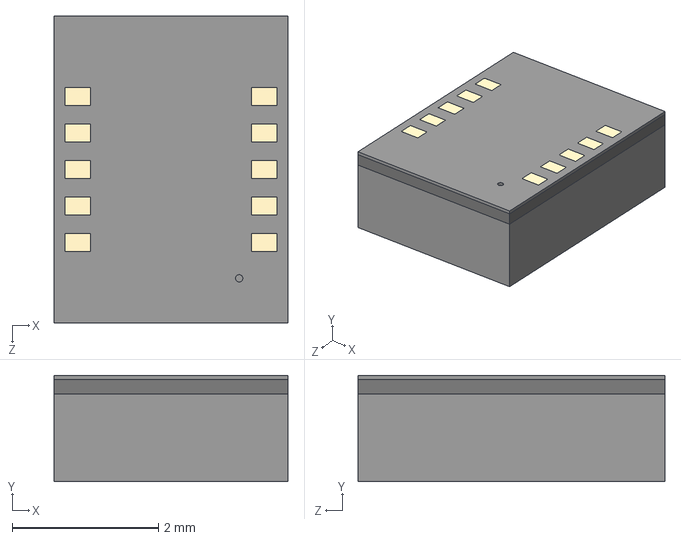
[picture p43: CAD file, 2024-09-23]
projectlibraries/inputs/STHS34PF80TR.stp
3.20 x 1.45 x 4.20 mm
