Strooom/LoRa-V3-PCB/projectlibraries/inputs/2-1734839-4.stp

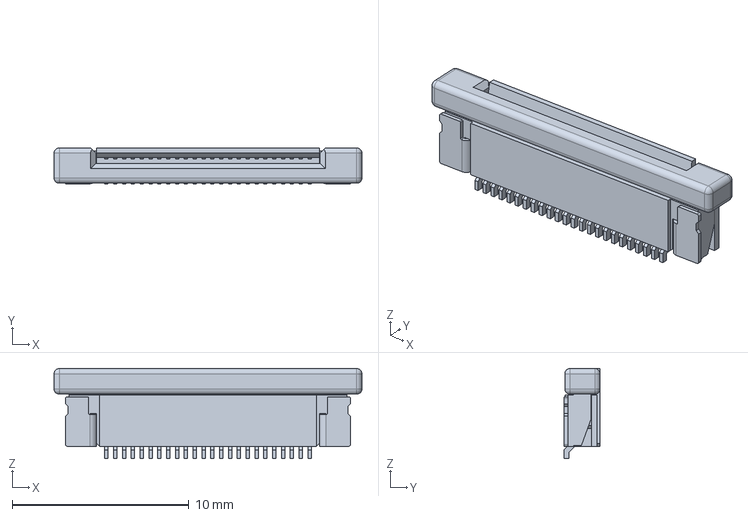
[picture p44: CAD file, 2024-09-23]
projectlibraries/inputs/2-1734839-4.stp
17.4 x 2.05 x 5.11 mm
