Strooom/LoRa-V3-PCB/projectlibraries/inputs/SSCM120100.STEP

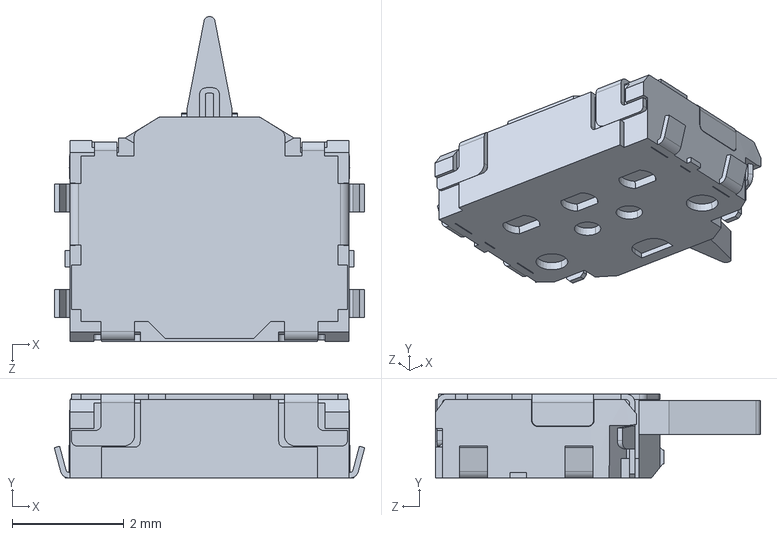
[picture p45: CAD file, 2024-09-23]
projectlibraries/inputs/SSCM120100.STEP
5.56 x 1.50 x 5.82 mm
