Strooom/LoRa-V3-PCB/projectlibraries/inputs/LIS3DH.step

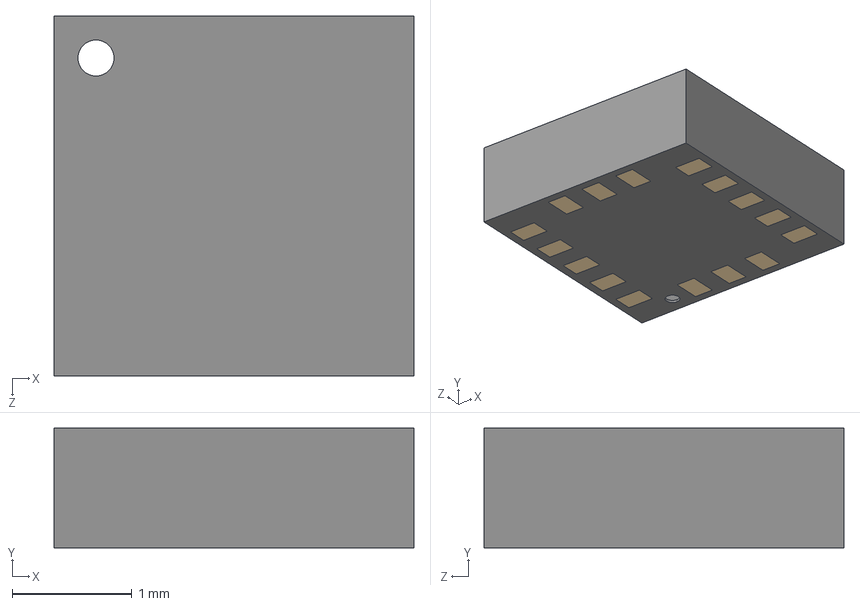
[picture p46: CAD file, 2024-09-23]
projectlibraries/inputs/LIS3DH.step
3.00 x 1.00 x 3.00 mm
