Strooom/LoRa-V3-PCB/projectlibraries/inputs/User Library-DFN10(3x3).step

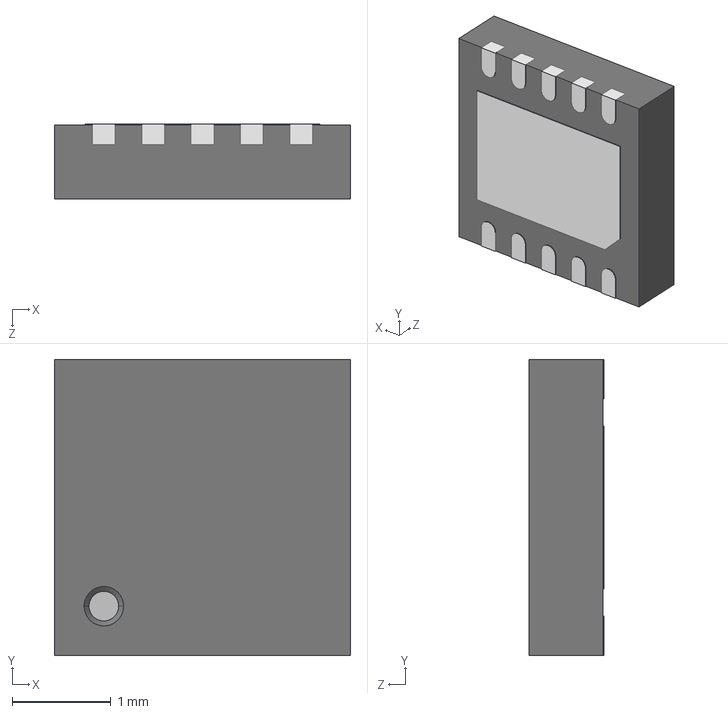
[picture p47: CAD file, 2024-09-23]
projectlibraries/inputs/User Library-DFN10(3x3).step
3.00 x 3.00 x 0.76 mm
