Strooom/LoRa-V3-PCB/projectlibraries/inputs/Download_STP_60311002111526 (rev1).stp

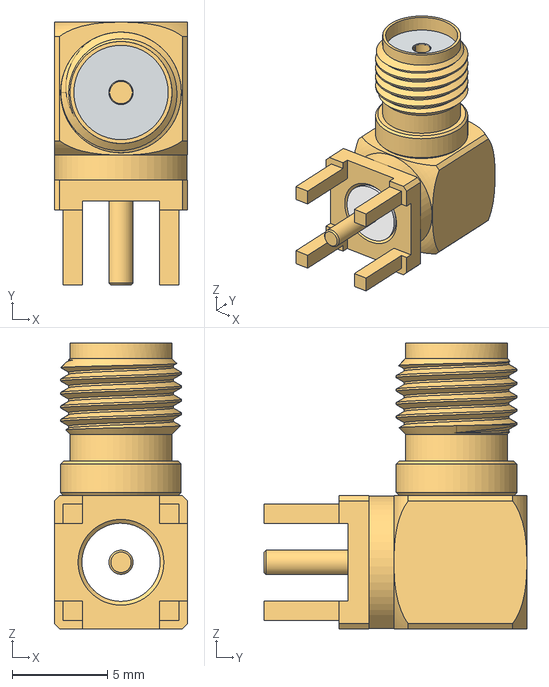
[picture p48: CAD file, 2024-09-23]
projectlibraries/inputs/Download_STP_60311002111526 (rev1).stp
7.00 x 13.8 x 15.0 mm
