Strooom/LoRa-V3-PCB/projectlibraries/inputs/SI2319CDS-T1-GE3.stp

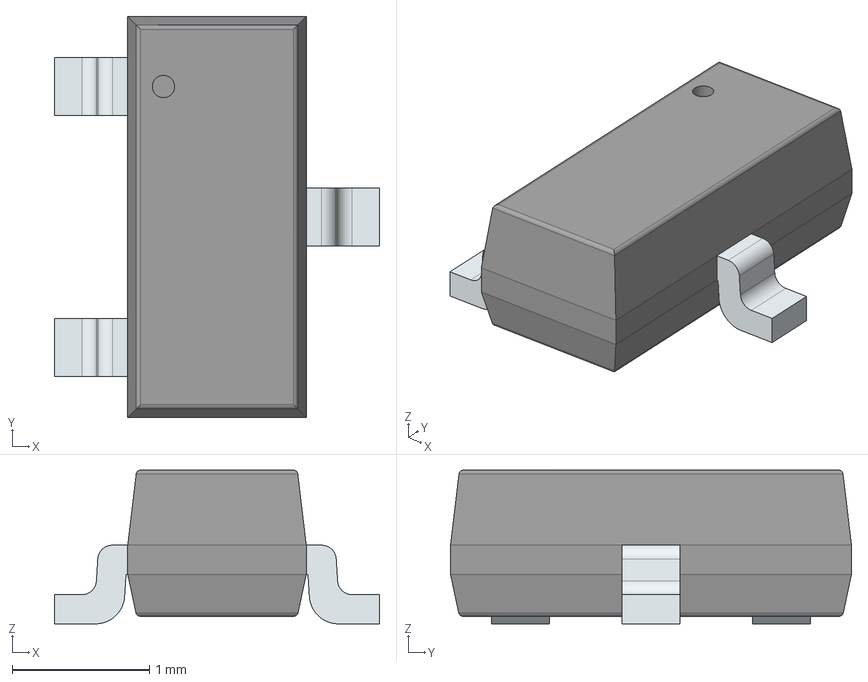
[picture p49: CAD file, 2024-09-23]
projectlibraries/inputs/SI2319CDS-T1-GE3.stp
2.37 x 2.92 x 1.12 mm
PinsArrayL
FilletPinR
