Strooom/LoRa-V3-PCB/(list of files, cad)

Other CAD files:
inputs/3dmodels/73391-0080.stp
projectlibraries/inputs/2171790001.stp
projectlibraries/inputs/MCP73831T-5ACI_MC.step
