Strooom/LoRa-V3-PCB/todo.md

# ToDo's
1. upgrade the PCB stack to a 4 layer board : signal - GND - vdd/power - signal
2. move components away from battery connector
3. move 100n cap on reset close to MCU pin
