Strooom/LoRa-V3-PCB/(threads)

Thread 1 (2025-02-10):

MCU resets when SPI/Display power is enabled

Strooom, 2025-02-10:
Solution : reduce C22 to 4.7uF, increase C10 to 10 uF and C24 to 2 * 10 uF

Strooom, 2025-04-23:
solved by providing a slow charging of the power rail via an extra GPIO

Closed 2025-04-23.

Thread 2 (2025-02-10):

Power rails do not turn off completely

Strooom, 2025-02-10:
1M pullup value is too high
330K is better, but maybe the PP output can stay on and no resistor is needed at all.. -> do power measurement

Closed 2025-04-23.

Thread 4 (2025-02-11):

add PC9 as slow charge for EPD power rail

Strooom, 2025-02-11:
Otherwise enabling the power rail causes a surge causing a brownout in the MCU

Strooom, 2025-04-23:
done

Closed 2025-04-23.

Thread 5 (2025-02-12):

Provide a production variant which permanently enables power to rail 1 to avoid inrush

Strooom, 2025-02-12:
through a solder bridge or 0 ohm resistor

Strooom, 2025-04-23:
added a solder bridge to enable permanent on of sensors power rail

Closed 2025-04-23.

Thread 6 (2025-02-17):

Tie ship-mode to GND

Strooom, 2025-02-17:

Strooom, 2025-04-23:
declined as the epeas energy harvester was replaced with a TI variant

Closed 2025-04-23.
