Strooom/LoRa-V3-PCB/outputs/pcb/LoRa-V3-PCB-assembly.pdf

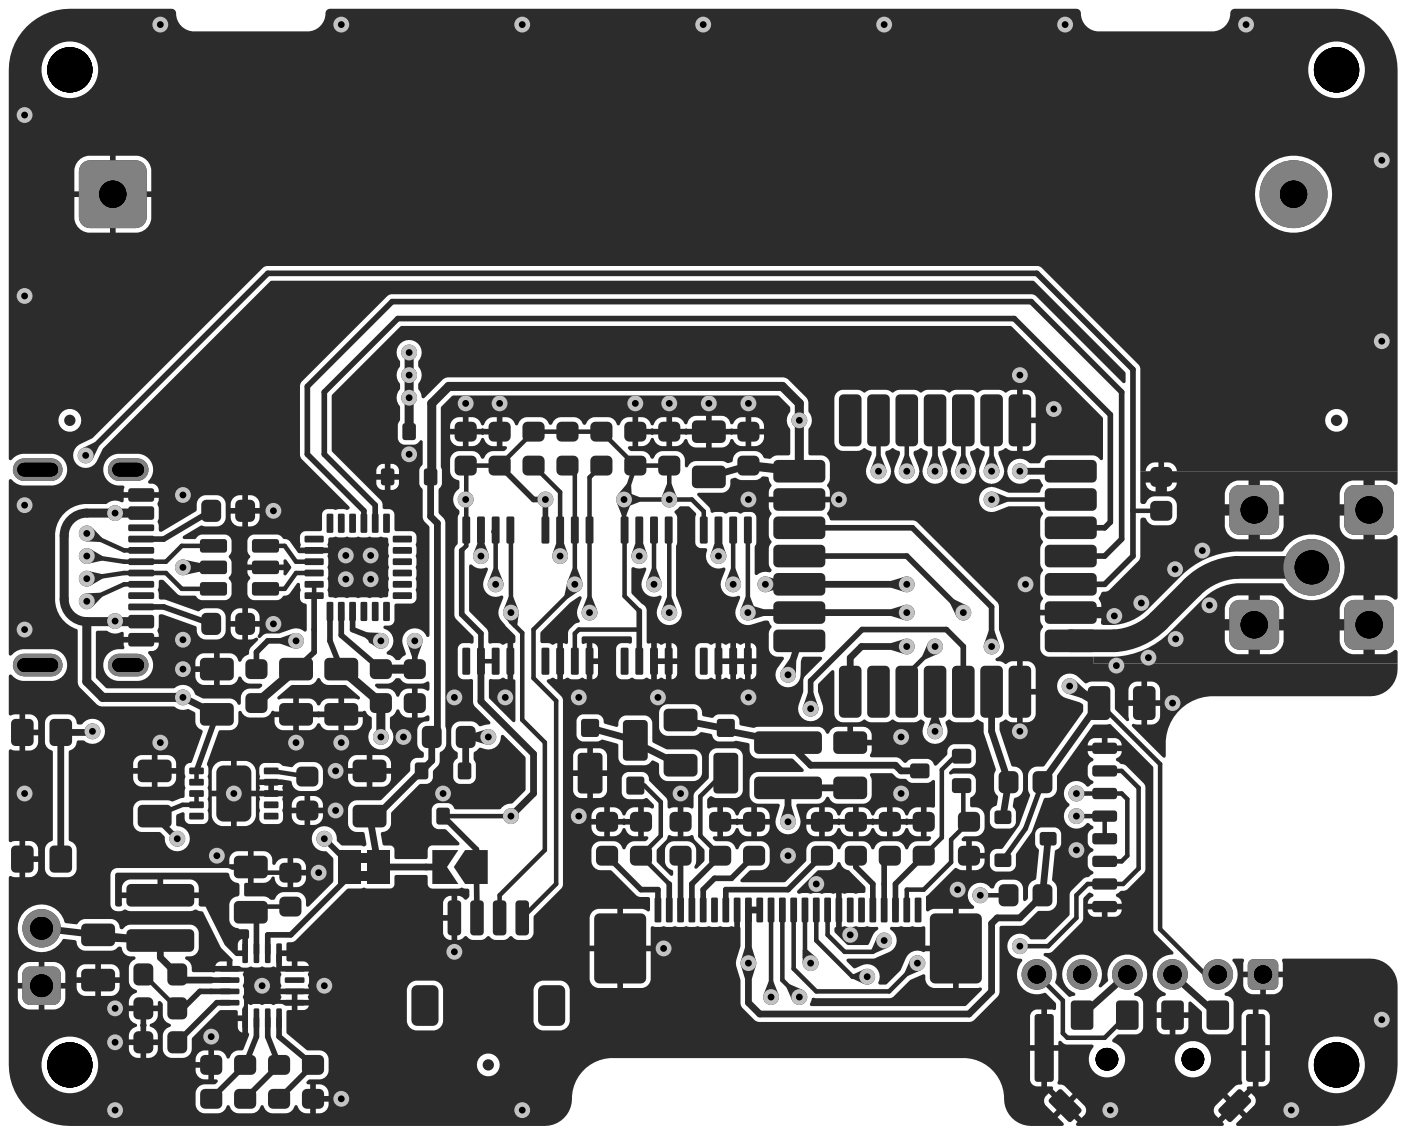
[picture p50: page 1]

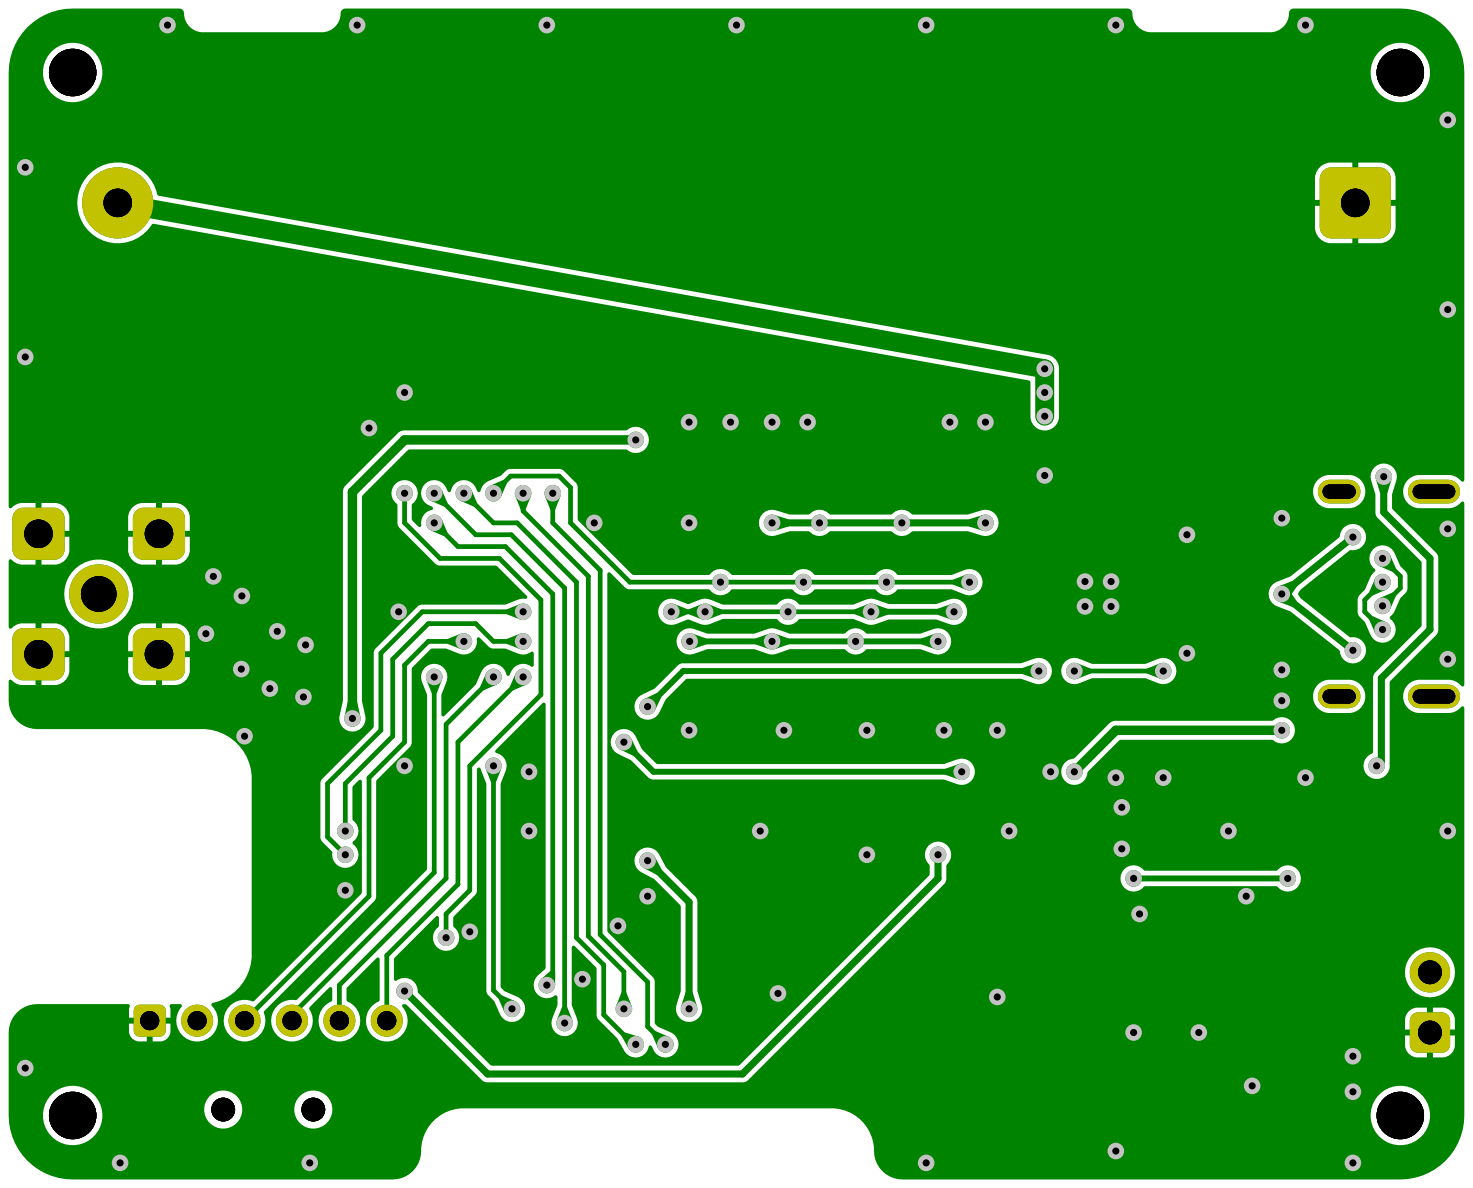
[picture p51: page 3]

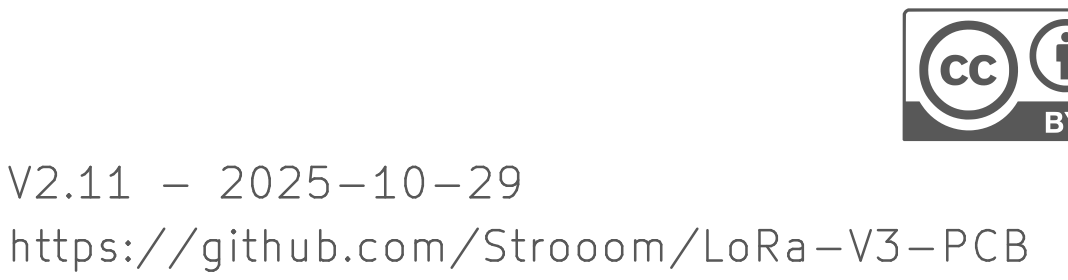
[picture p52: page 4]

https://github.com/Strooom/LoRa-V3-PCB
