Strooom/LoRa-V3-PCB/outputs/schematic/LoRa-V3-PCB-schematic.pdf

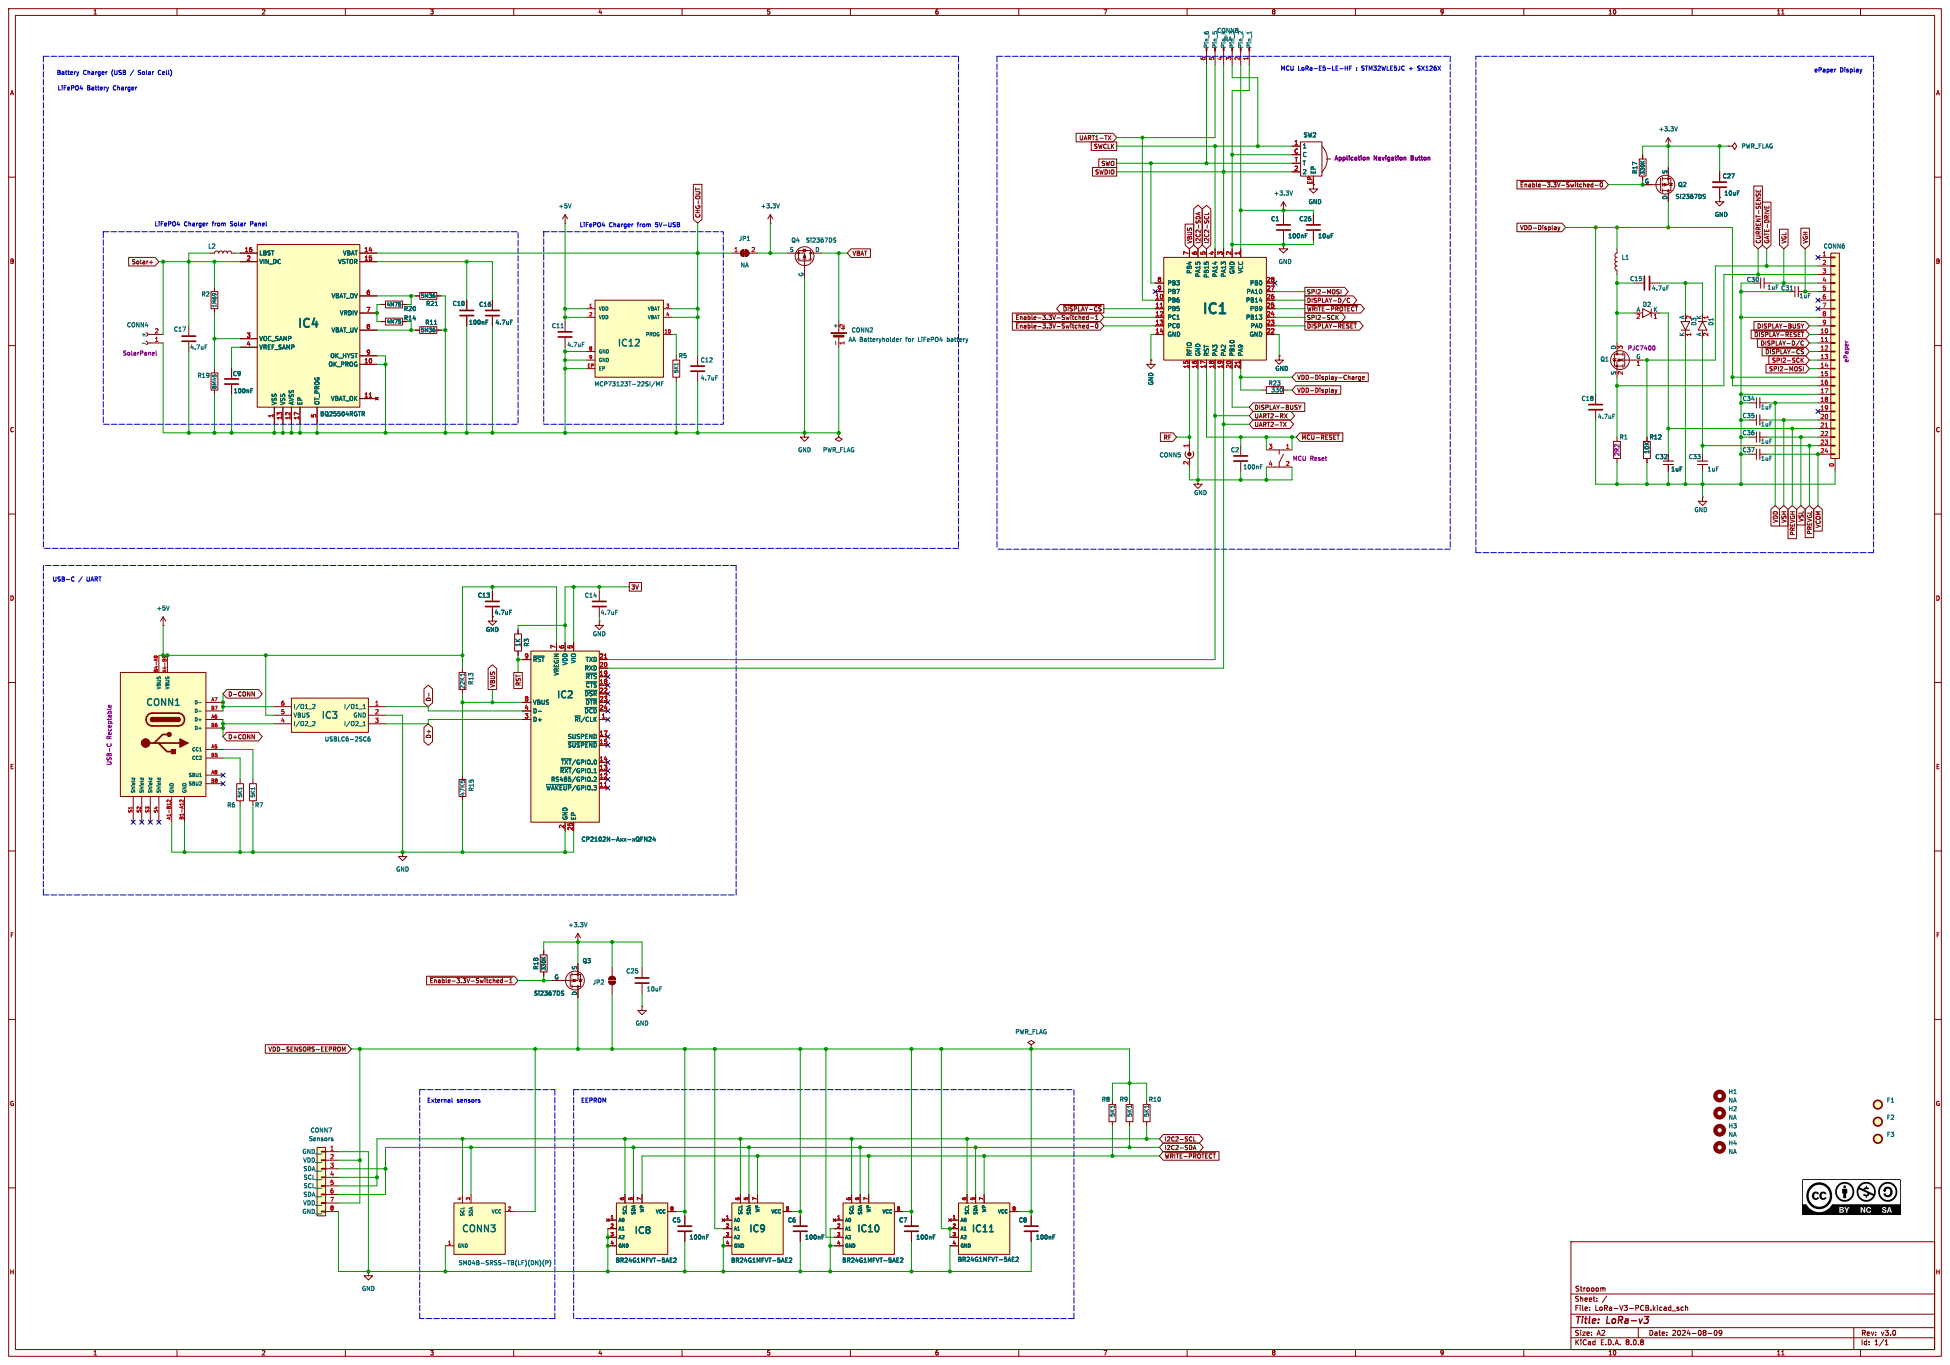
[picture p53: page 1]

2 CONN2 AA Batteryholder for LiFePO4 battery +3.3V C32

1 OK_PROG 10 VBAT_OK 11 AVSS 12 VSS 13 VBAT 14 VSTOR 15

1 PB6 10 PB5 11 PC1 12 PC0 13 GND 14 RFIO 15 GND 16 RST 17 PA3 18 PA2 19 GND

VDD-Display-Charge DISPLAY-D/C
~{WRITE-PROTECT} SPI2-SCK

2 RXD 20 TXD 21 ~{DSR} 22 ~{DTR} 23 ~{DCD} 24 EP 25 D+ 3 D- 4 VIO

SM04B-SRSS-TB(LF)(DN)(P)

File: LoRa-V3-PCB.kicad_sch Sheet: / Strooom
