Strooom/LoRa-V3-PCB/outputs/gerber/LoRa-V3-PCB-Drill_Map.pdf

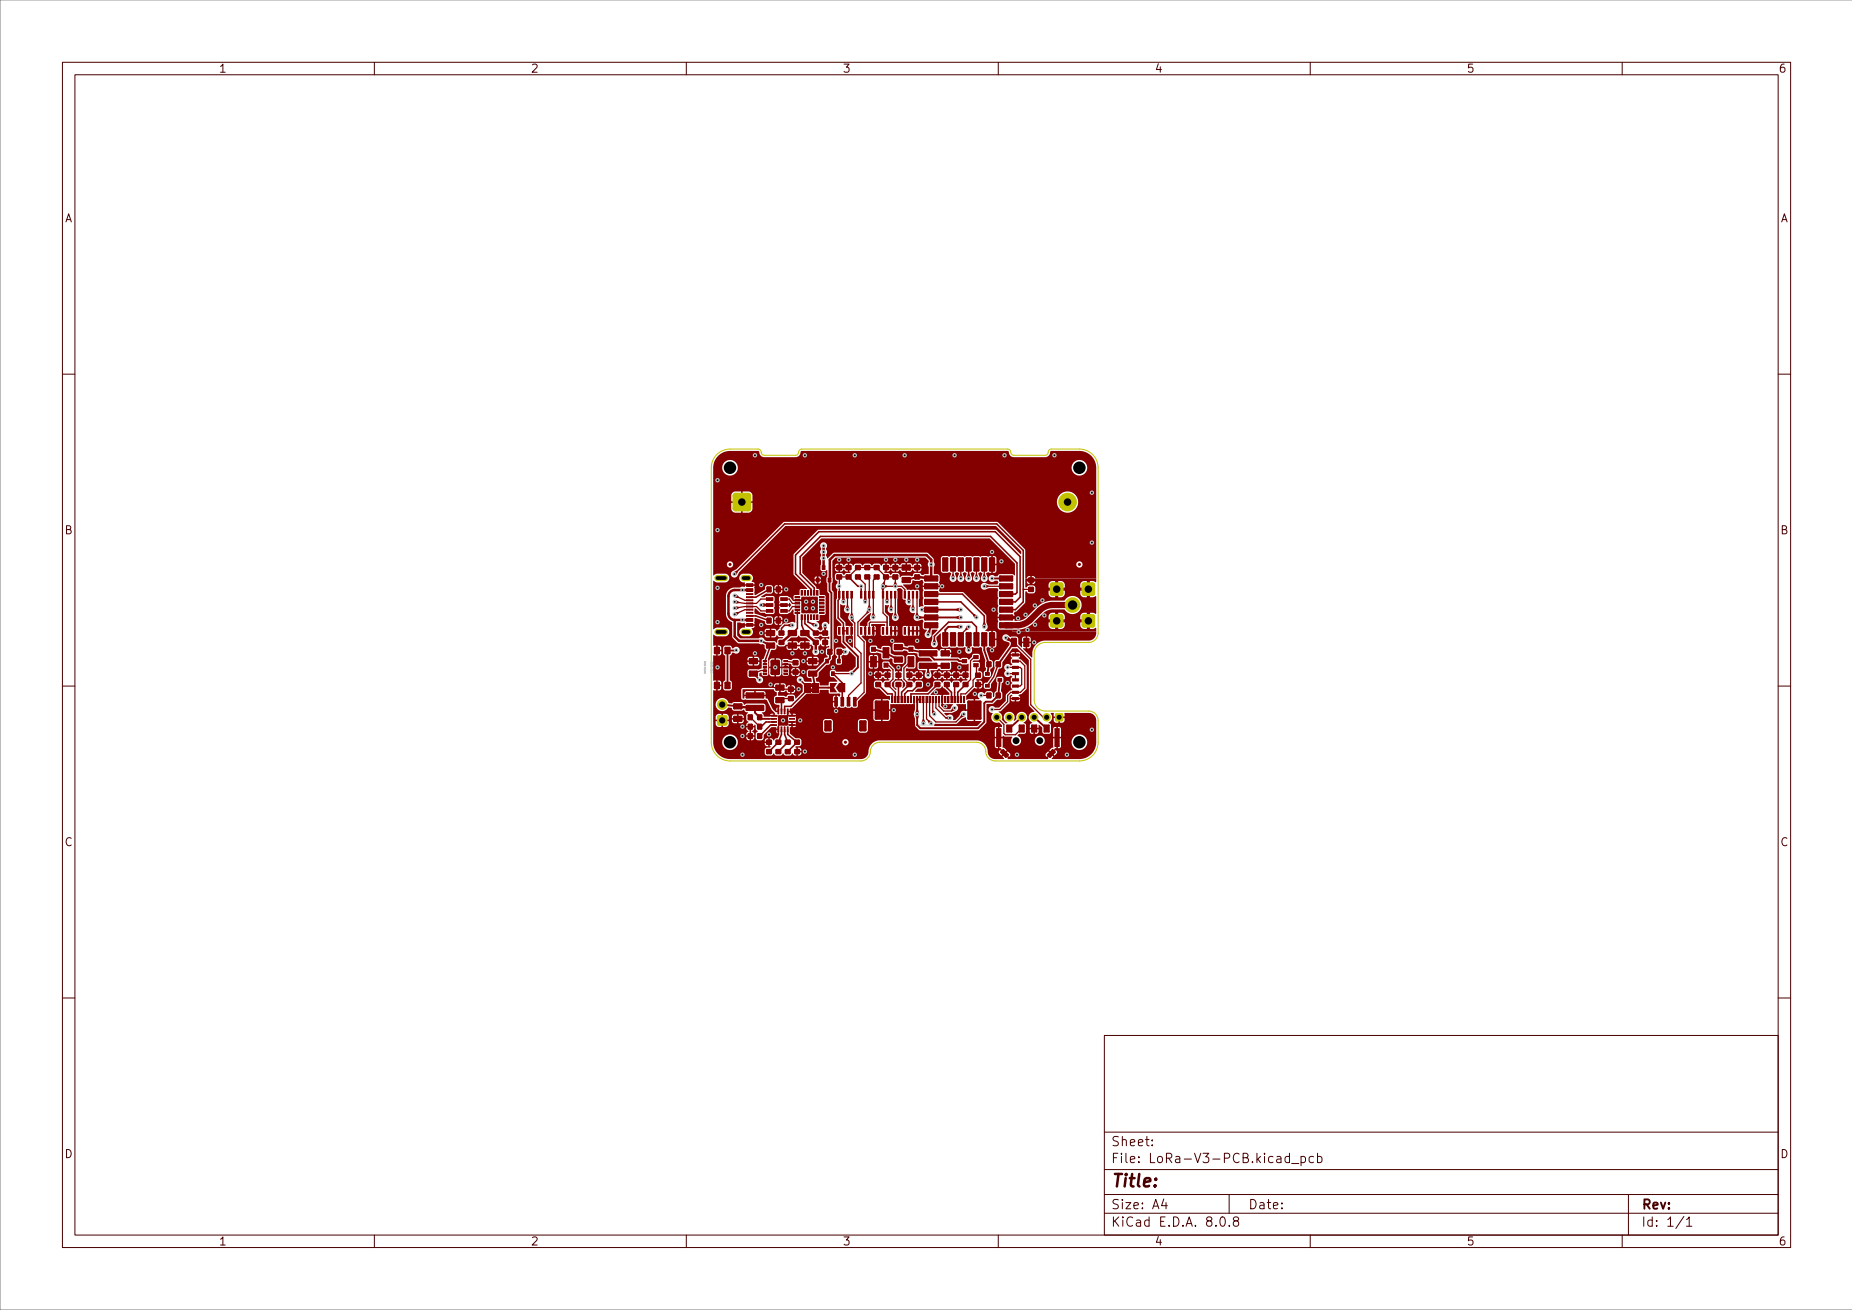
[picture p54: page 1]
