Strooom/LoRa-V3-PCB/outputs/drill/LoRa-V3-PCB-drill_map.pdf

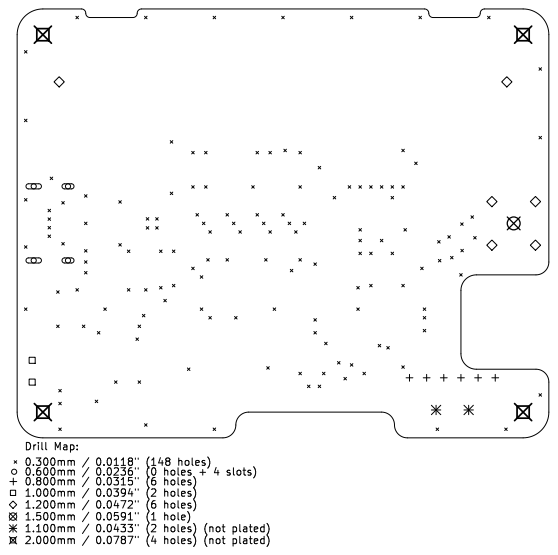
[picture p55: page 1]
