Strooom/LoRa-V3-PCB/outputs/drill/LoRa-V3-PCB-NPTH_drill_map.pdf

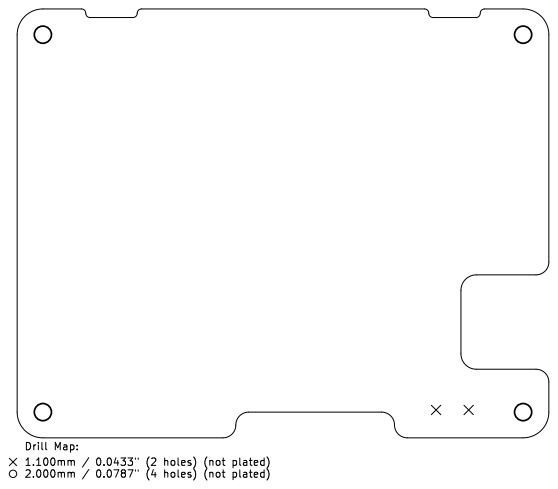
[picture p56: page 1]
