Strooom/LoRa-V3-PCB/outputs/drill/LoRa-V3-PCB-PTH_drill_map.pdf

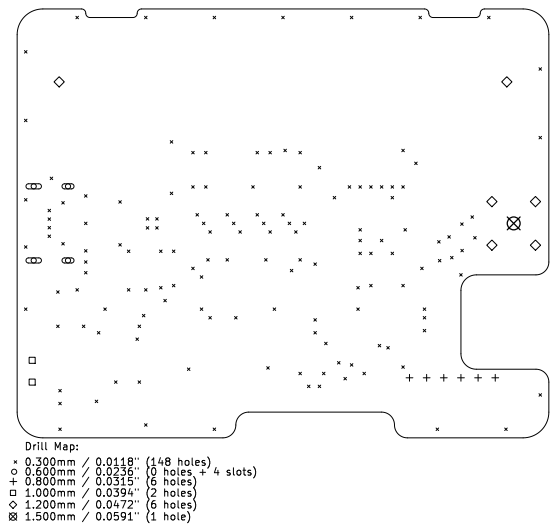
[picture p57: page 1]
