Strooom/LoRa-V3-PCB/inputs/certification/FCC ID_DSS LoRa-E5-LE-HF.pdf

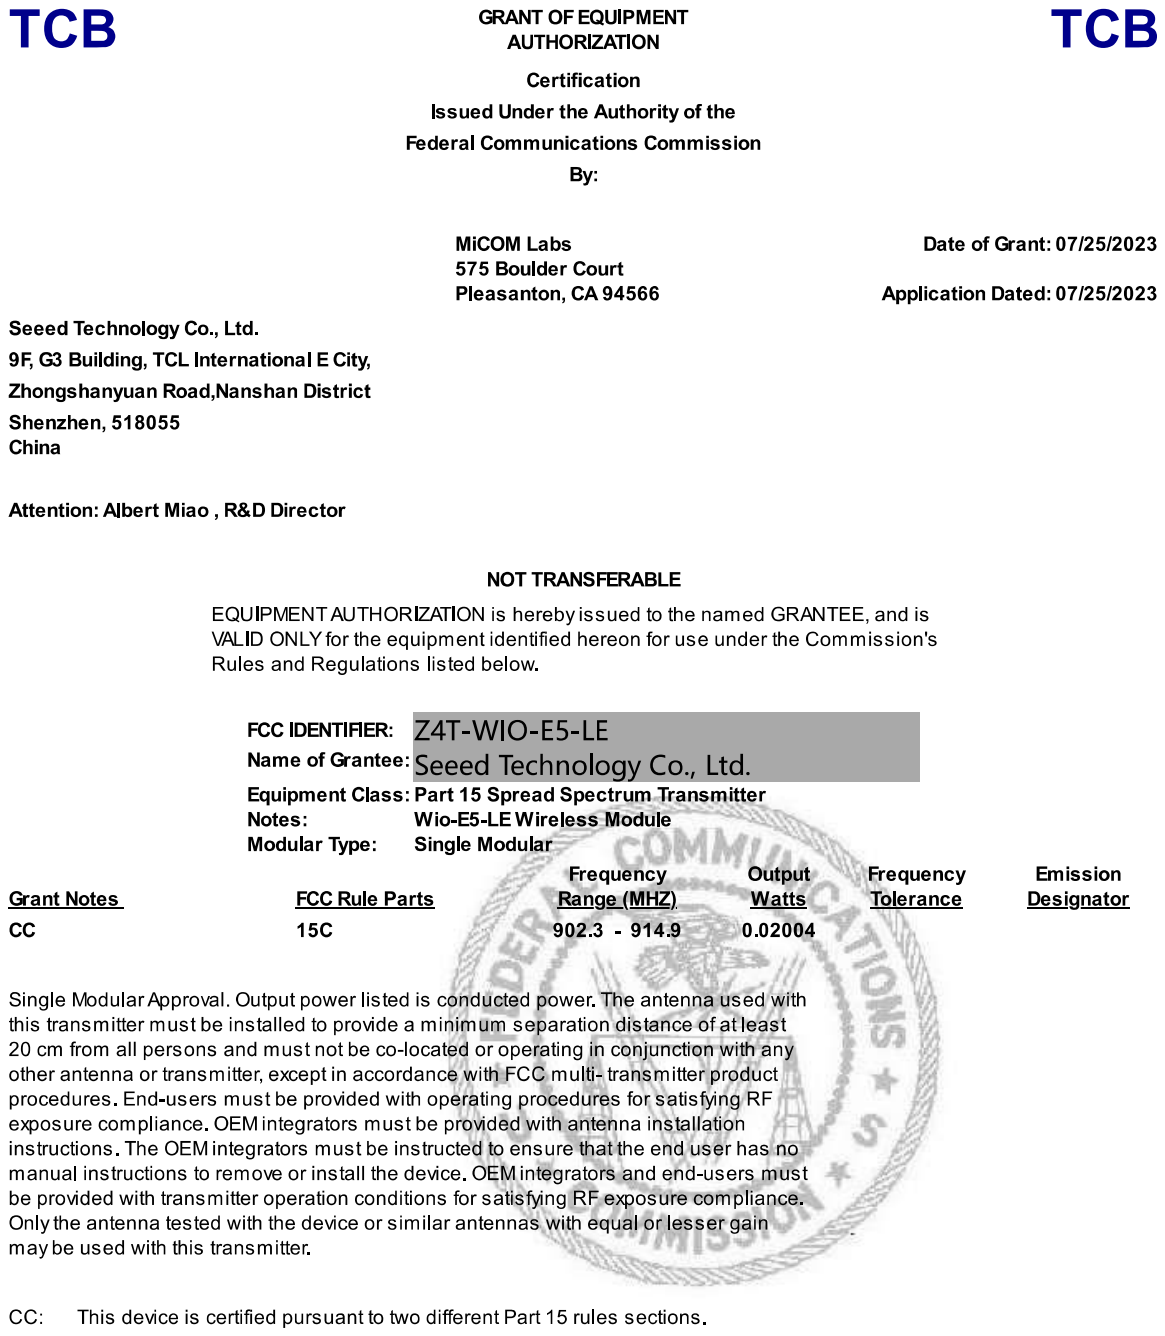
[picture p58: page 1]
