Strooom/LoRa-V3-PCB/inputs/certification/FCC ID_DTS LoRa-E5-LE-HF.pdf

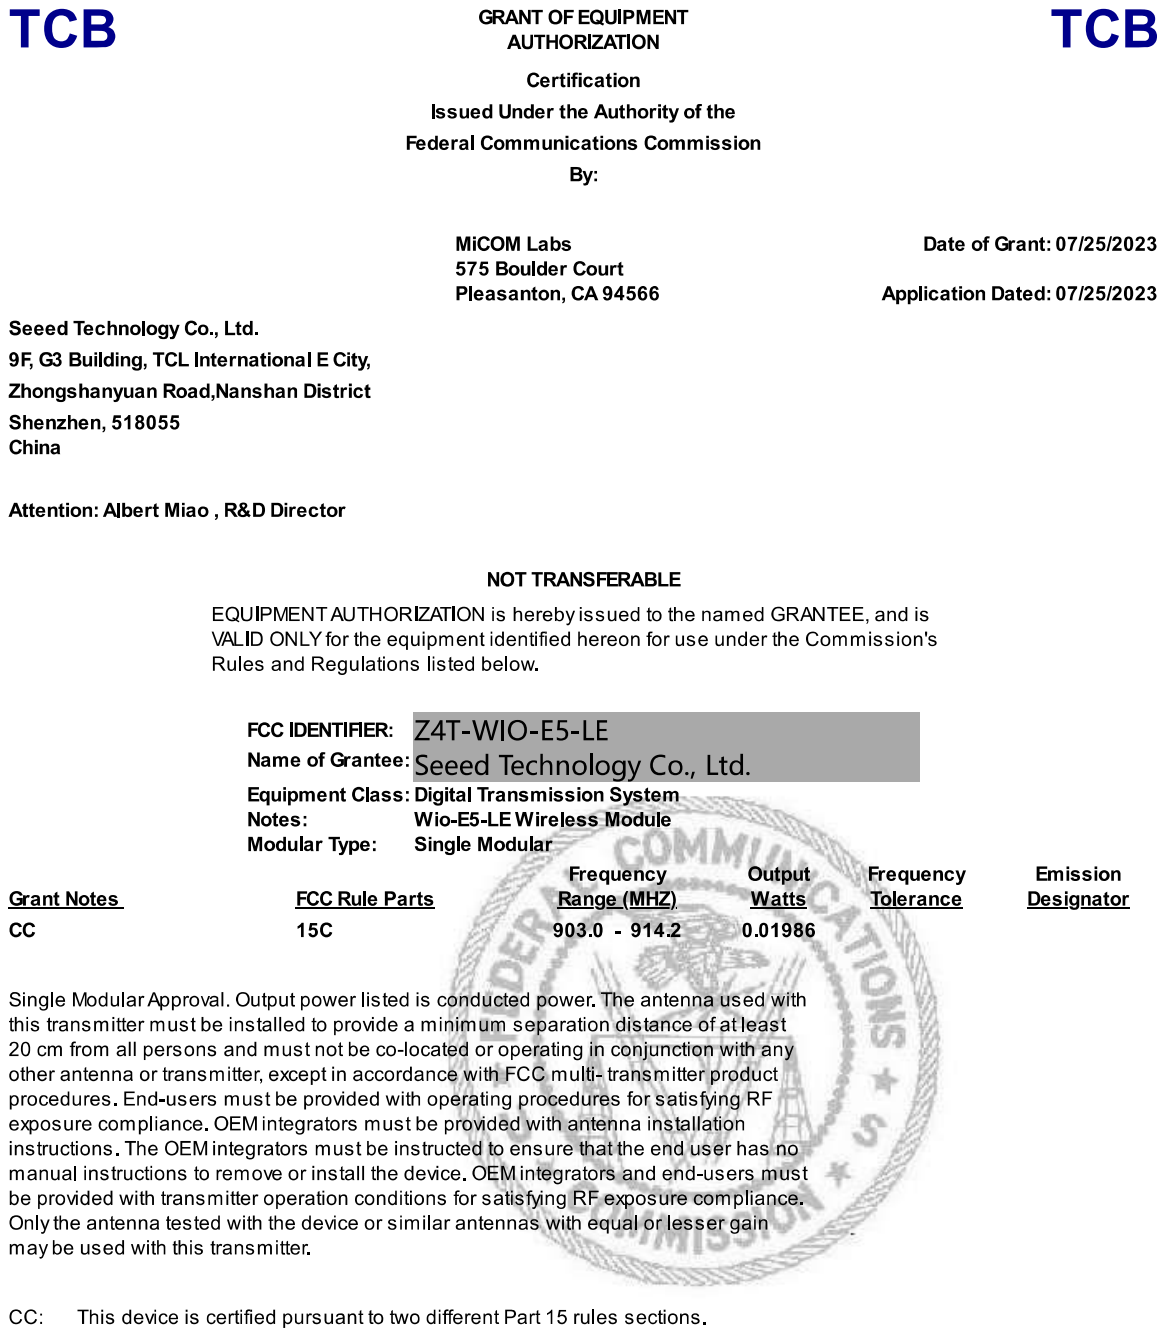
[picture p59: page 1]
