Strooom/LoRa-V3-PCB/LoRa-V3-PCB.kicad_pcb

## KiCad design LoRa-V3-PCB.kicad_pcb (2025-10-27)

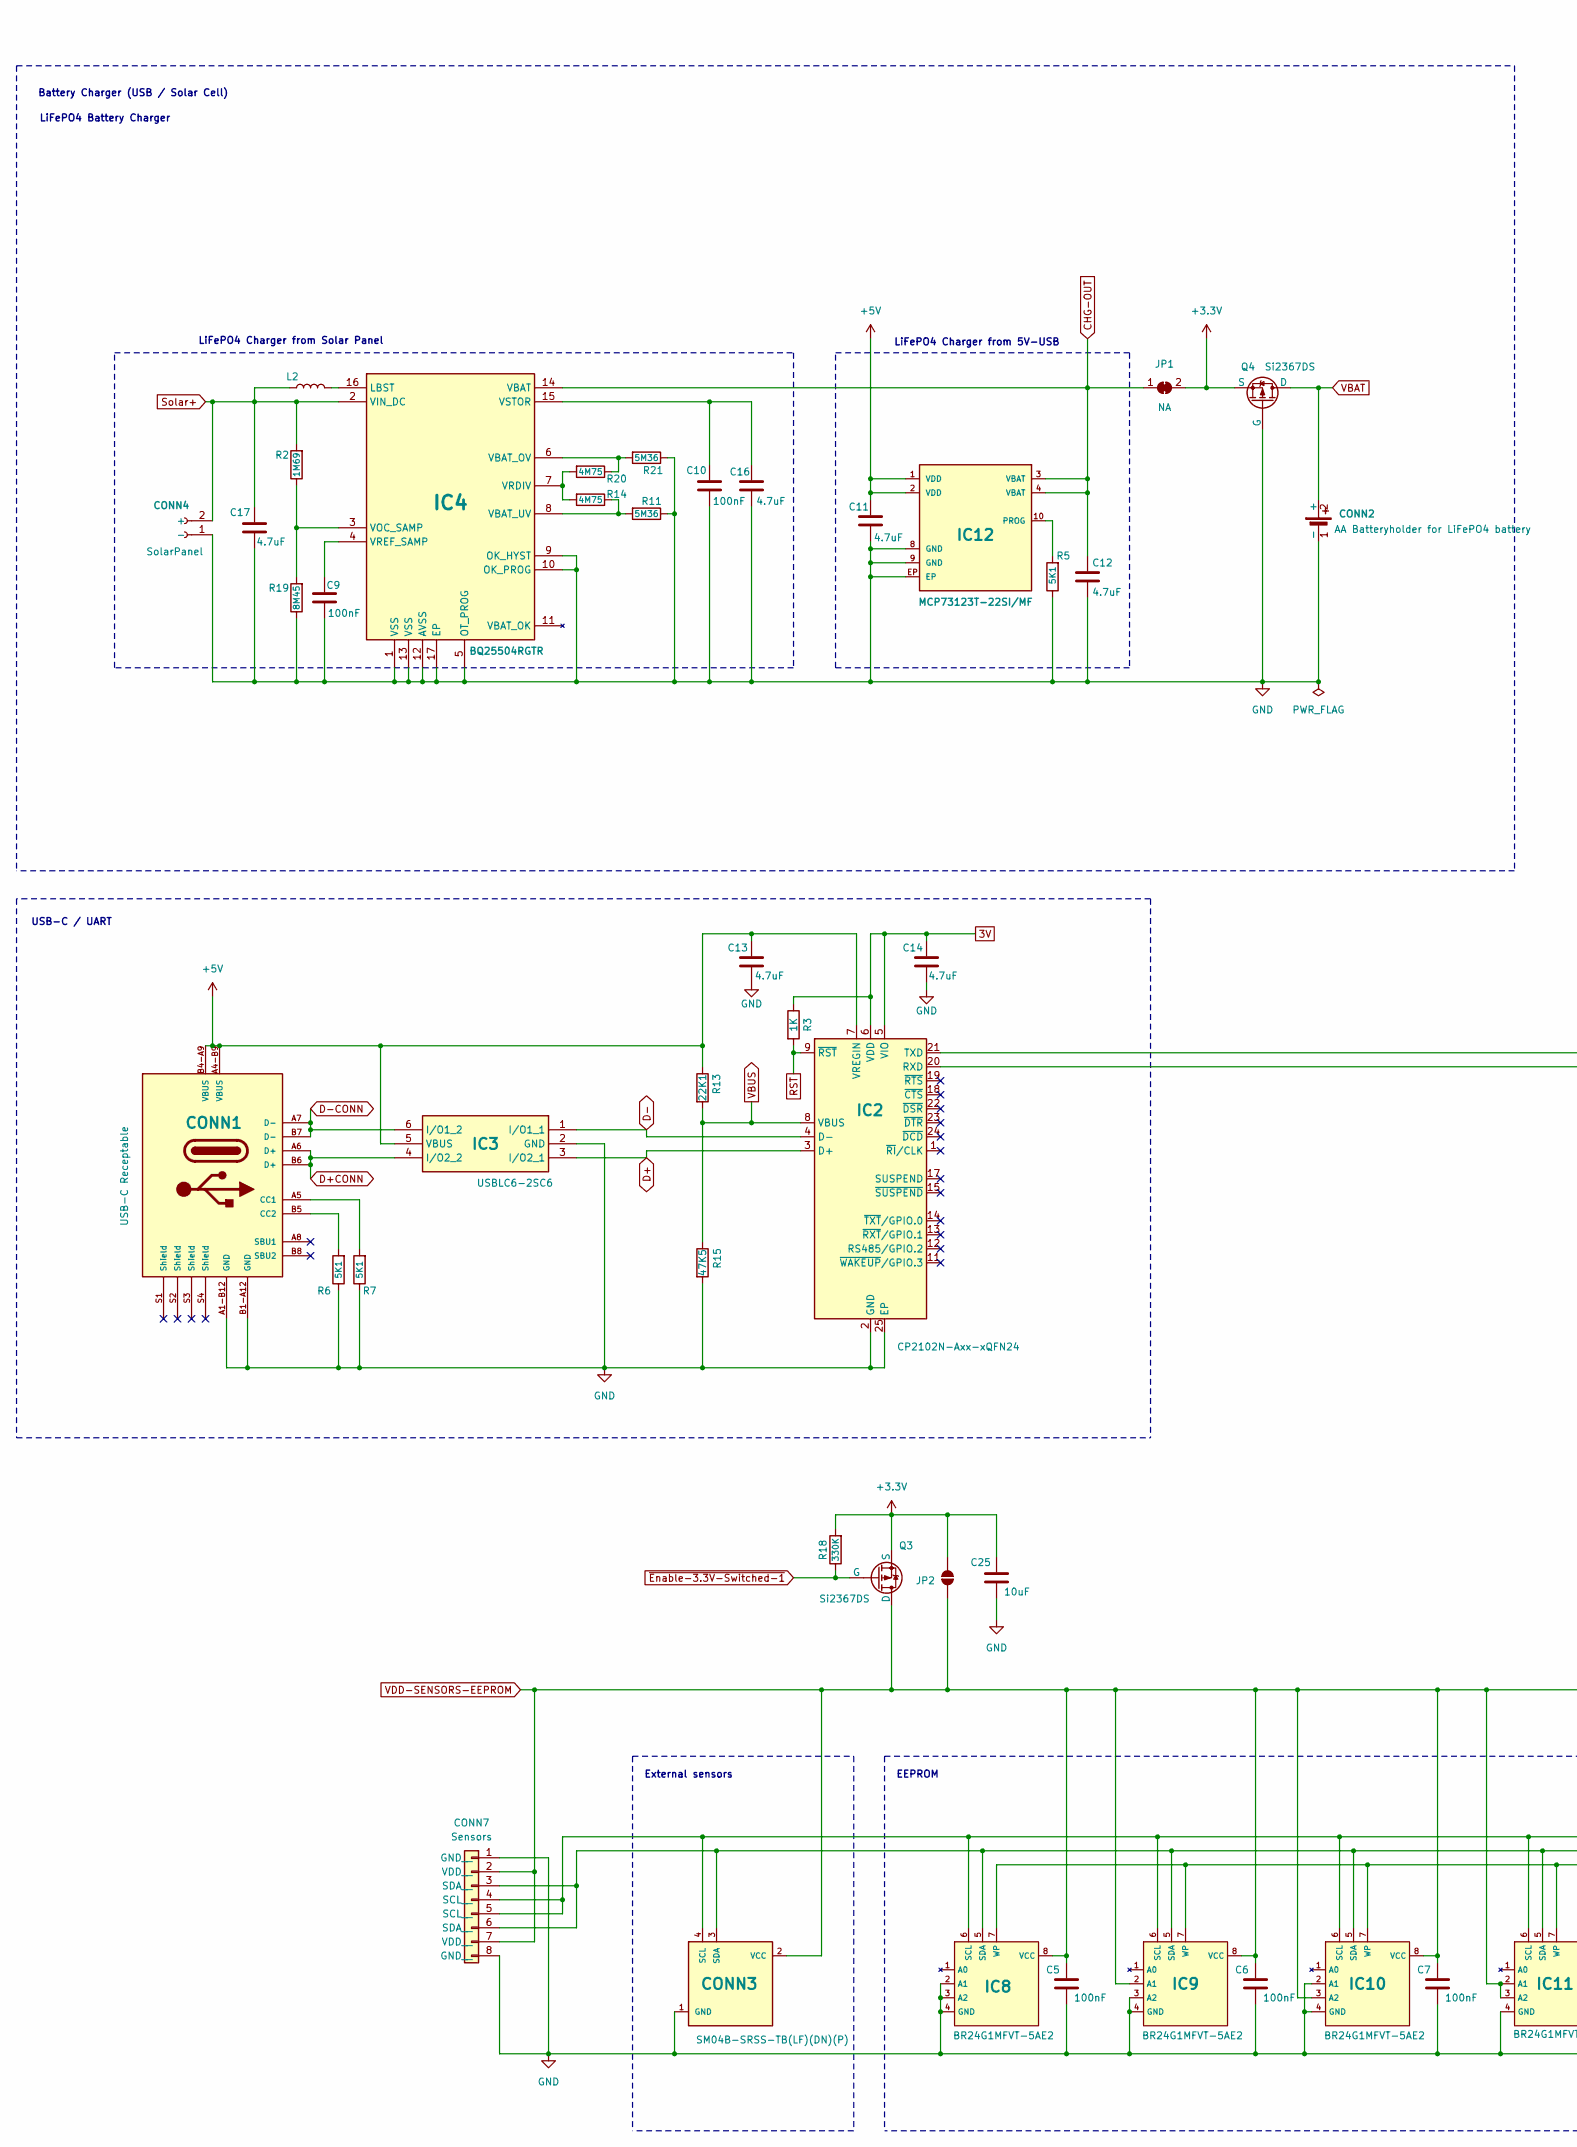
[picture p60: schematic LoRa-V3-PCB.kicad_sch, LoRa-v3, part in row 1, column 1]

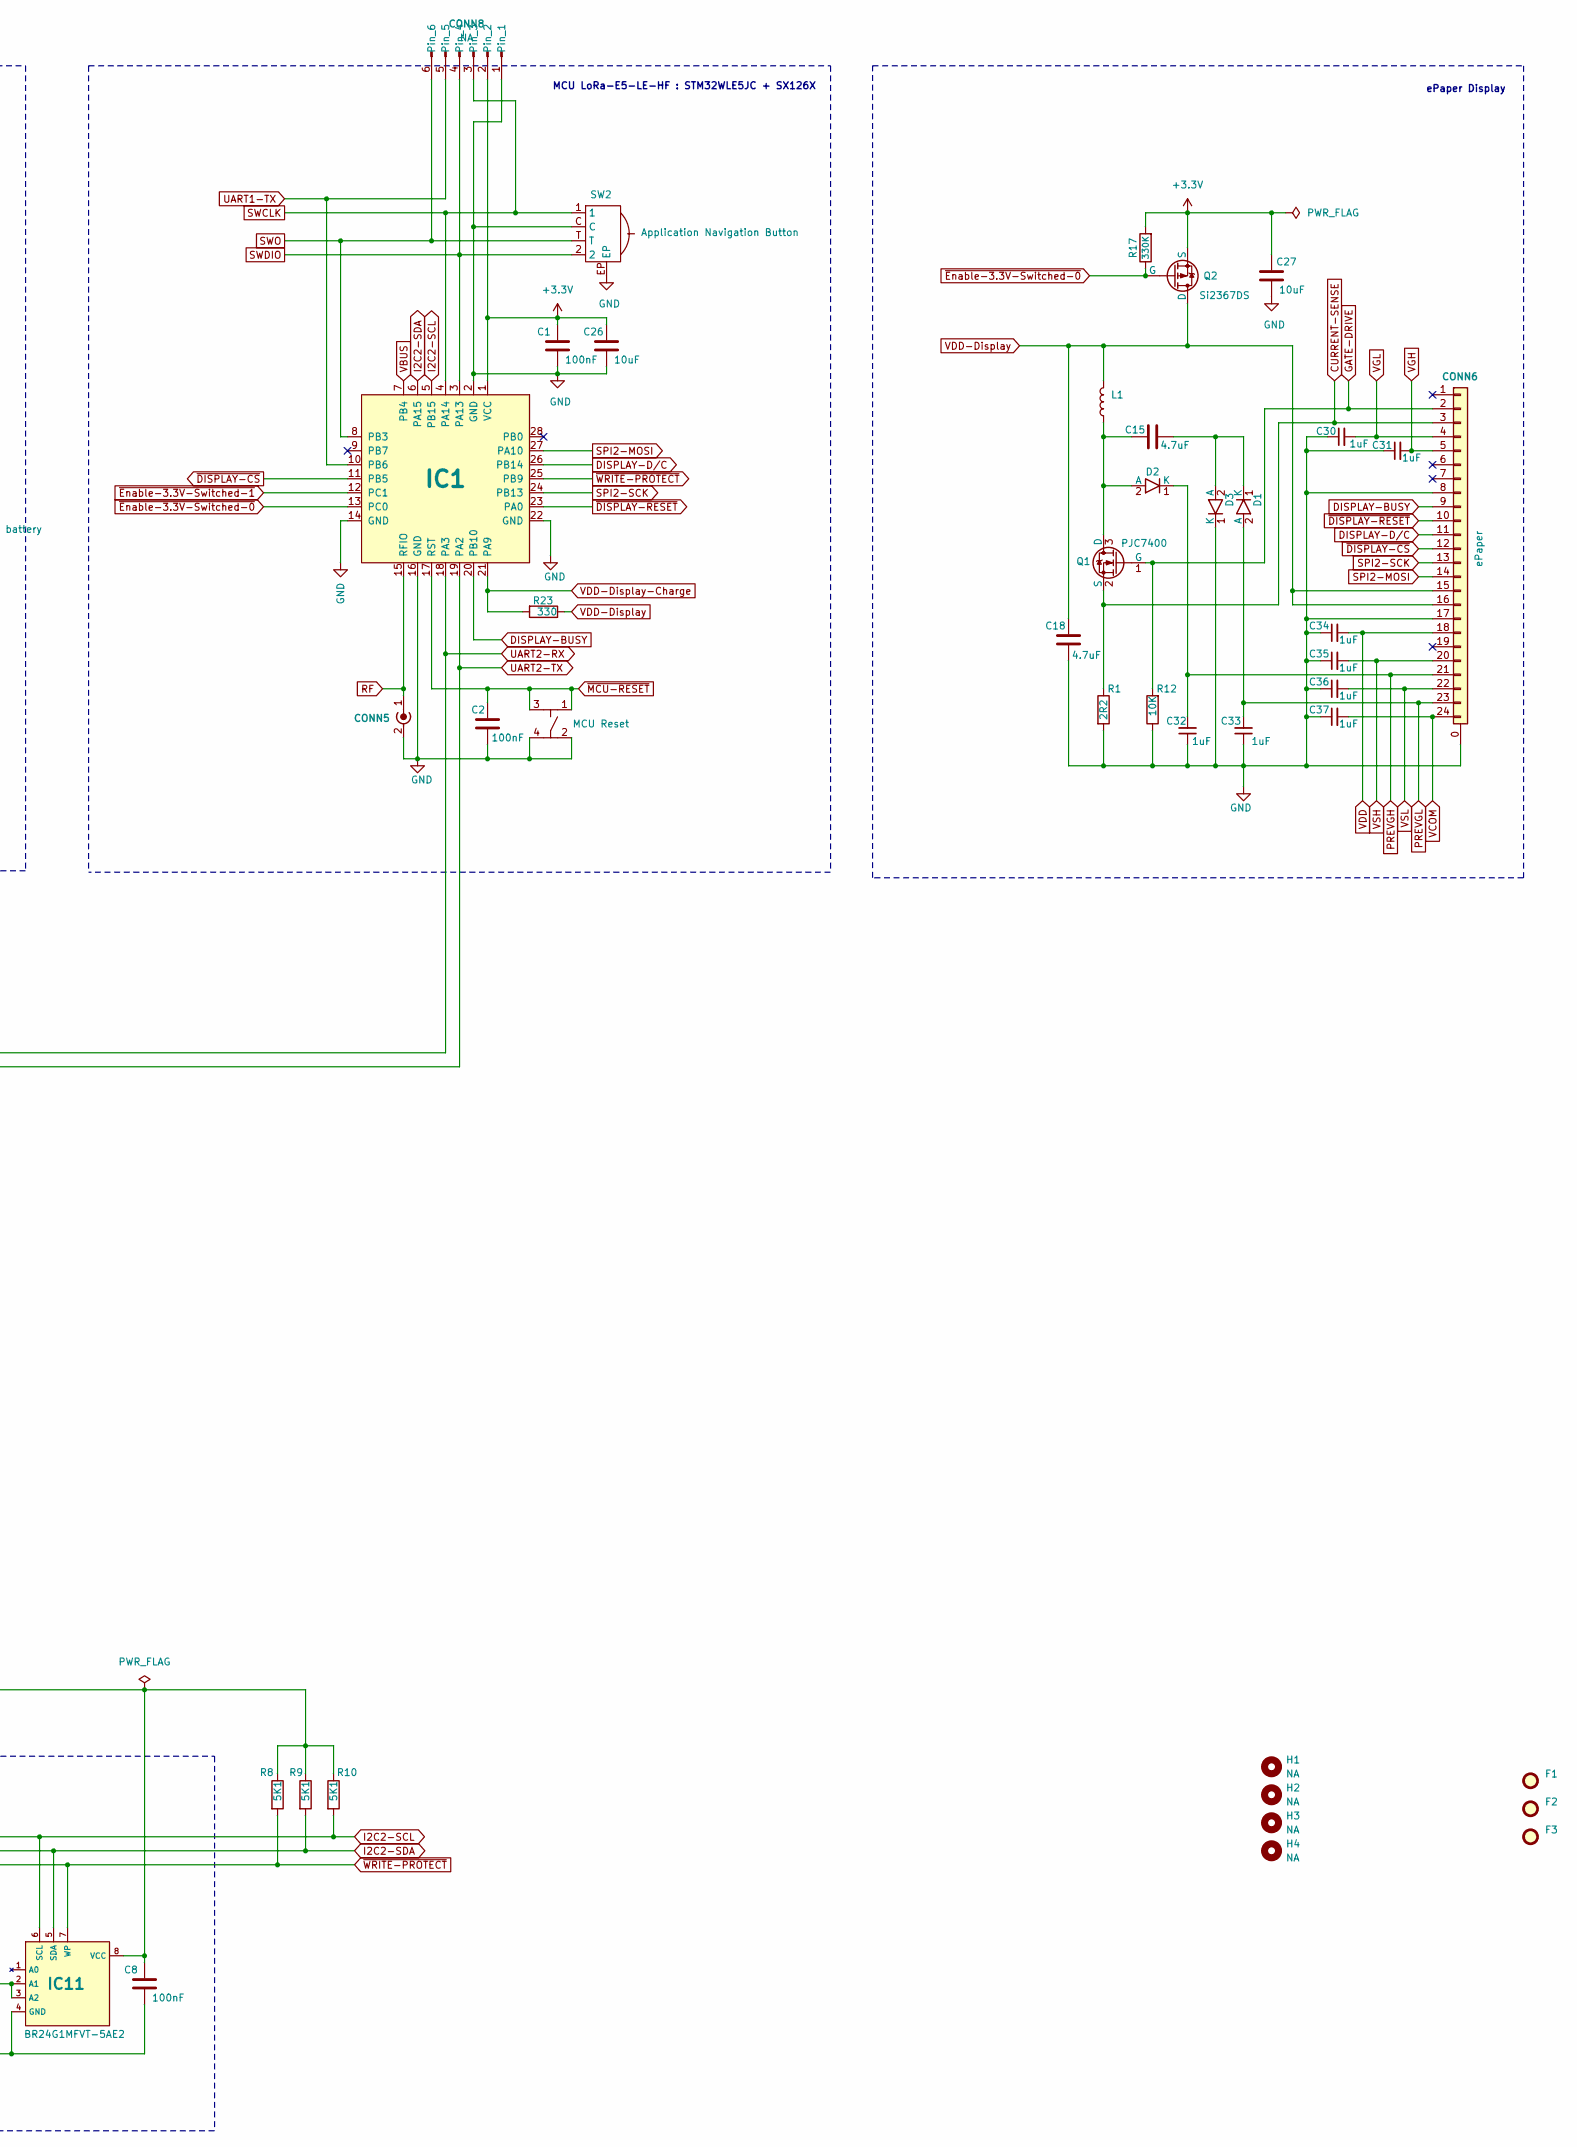
[picture p61: schematic LoRa-V3-PCB.kicad_sch, LoRa-v3, part in row 1, column 2]

Parts:
C1, C2, C5, C6, C7, C8, C9, C10: 100nF; C_0603_nominal; manufacturerPartNumber CGA3E2X7R1E104K080AA
C11, C12, C13, C14, C15, C16, C17, C18: 4.7uF; C_0805; manufacturerPartNumber CL21B475KPFNFNE
C25, C26, C27: 10uF; C_0805; manufacturerPartNumber CL21B106KPQNNWE
C30, C31, C32, C33, C34, C35, C36, C37: 1uF; C_0603_nominal; manufacturerPartNumber CGA3E1X7R1E105K080AC
CONN1: 217179-0001; Molex-2171790001; manufacturerPartNumber 217179-0001
CONN2: AA Batteryholder for LiFePO4 battery; BAT_2460; manufacturerPartNumber 2460
CONN3: SM04B-SRSS-TB(LF)(DN)(P); JST_SH_SM04B-SRSS-TB_1x04-1MP_P1.00mm_Horizontal; manufacturerPartNumber SM04B-SRSS-TB(LF)(DN)(P)
CONN4: NA; PinHeader_1x02_P2.54mm_Vertical; manufacturerPartNumber B2B-XH-A(LF)(SN)
CONN5: 73391-0080; Molex 73391-0080; manufacturerPartNumber 73391-0080
CONN6: 2-1734839-4; TE_2-1734839-4_1x24-1MP_P0.5mm_Horizontal; manufacturerPartNumber 2-1734839-4
CONN7: Sensors; GCT_BC075-08-A-L-A; manufacturerPartNumber BC075-08-A-L-A
CONN8: NA; Debug_PinHeader_1x06_P2.00mm_Vertical; manufacturerPartNumber NA
D1, D2, D3: MSS1P3HM3_A/H; MSS1P3; manufacturerPartNumber MSS1P3HM3_A/H
F1, F2, F3: NA; Fiducial_0.5mm_Mask1mm; manufacturerPartNumber NA
H1, H2: NA; MountingHole_2mm_noCourtyard; manufacturerPartNumber NA
H3, H4: NA; MountingHole_2mm; manufacturerPartNumber NA
IC1: SeeedStudio Wio-E5-LE-HF; LoRa-E5; manufacturerPartNumber 114993121
IC2: CP2102N-Axx-xQFN24; QFN24-CP2102N; manufacturerPartNumber CP2102N-A02-GQFN24R
IC3: USBLC6-2SC6; SOT-23-6L-USBLC6-2; manufacturerPartNumber USBLC6-2SC6
IC4: BQ25504RGTR; VQFN-16-1EP_3x3mm_P0.5mm_EP1.6x1.6mm_ThermalVias; manufacturerPartNumber BQ25504RGTR
IC8, IC9, IC10, IC11: BR24G1MFVT-5AE2; BR24G1M-TSSOP-B8; manufacturerPartNumber BR24G1MFVT-5AE2
IC12: MCP73123T-22SI/MF; DFN10_MCP73123; manufacturerPartNumber MCP73123T-22SI/MF
JP1: NA; SolderJumper-2_P1.3mm_Bridged2Bar_Pad1.0x1.5mm; manufacturerPartNumber NA
JP2: NA; SolderJumper-2_P1.3mm_Open_TrianglePad1.0x1.5mm; manufacturerPartNumber NA
L1: 47uH; L_TDK_VLS3010CX; manufacturerPartNumber VLS3010CX-470M-1
L2: 22 uH; L_TDK_VLS3010CX; manufacturerPartNumber VLS3010CX-220M-1
Q1: PJC7400_R1_00001; SOT-323_PJC7400; manufacturerPartNumber PJC7400_R1_00001
Q2, Q3, Q4: Si2367DS; SI2367DS-SOT-23; manufacturerPartNumber SI2367DS-T1-GE3
R1: ERJ-3RQJ2R2V; R_0603_nominal; manufacturerPartNumber ERJ-3RQJ2R2V
R2: 1M69; R_0603_nominal; manufacturerPartNumber RC0603FR-071M69L
R3: 1K; R_0603_nominal; manufacturerPartNumber SR0603JR-071KL
R5, R6, R7, R8, R9, R10: 5K1; R_0603_nominal; manufacturerPartNumber AC0603DR-075K1L
R11, R21: 5M36; R_0603_nominal; manufacturerPartNumber CRCW06035M36FKEA
R12: 10K; R_0603_nominal; manufacturerPartNumber CR0603-JW-103ELF
R13: 22K1; R_0603_nominal; manufacturerPartNumber AC0603FR-0722K1L
R14, R20: 4M75; R_0603_nominal; manufacturerPartNumber RC0603FR-074M75L
R15: 47K5; R_0603_nominal; manufacturerPartNumber AC0603FR-0747K5L
R17, R18: 330K; R_0603_nominal; manufacturerPartNumber AC0603JR-07330KL
R19: 8M45; R_0603_nominal; manufacturerPartNumber RC0603FR-078M45L
R23: 330; R_0603_nominal; manufacturerPartNumber RC0603FR-7W330RL
SW1: 434331045822; Wurth-4343X10458XX; manufacturerPartNumber 434331045822
SW2: SLLB510100; manufacturerPartNumber SLLB510100

Connections:
3V: C14.1, IC2.5 (VIO), IC2.6 (VDD), R3.1
+3.3V: C1.1, C25.1, C26.1, C27.1, CONN8.2, IC1.1 (VCC), JP1.2 (B), JP2.2 (B), Q2.2 (S), Q3.2 (S), Q4.2 (S), R17.2, R18.2
+5V: C11.1, C13.1, CONN1.A4-B9 (VBUS), CONN1.B4-A9 (VBUS), IC2.7 (VREGIN), IC3.5 (VBUS), IC12.1 (VDD), IC12.2 (VDD), R13.1
CHG-OUT: C12.1, IC4.14 (VBAT), IC12.3 (VBAT), IC12.4 (VBAT), JP1.1 (A)
CURRENT-SENSE: CONN6.3, Q1.2 (S), R1.1
D+: IC2.3 (D+), IC3.3 (I/O2_1)
D+CONN: CONN1.A6 (D+), CONN1.B6 (D+), IC3.4 (I/O2_2)
D-: IC2.4 (D-), IC3.1 (I/O1_1)
D-CONN: CONN1.A7 (D-), CONN1.B7 (D-), IC3.6 (I/O1_2)
DISPLAY-BUSY: CONN6.9, IC1.20 (PB10)
DISPLAY-D/C: CONN6.11, IC1.26 (PB14)
GATE-DRIVE: CONN6.2, Q1.1 (G), R12.2
GND: C1.2, C2.2, C5.2, C6.2, C7.2, C8.2, C9.2, C10.2, C11.2, C12.2, C13.2, C14.2, C16.2, C17.2, C18.2, C25.2, C26.2, C27.2, C30.1, C31.1, C32.1, C33.1, C34.1, C35.1, C36.1, C37.1, CONN1.A1-B12 (GND), CONN1.B1-A12 (GND), CONN2.1 (-), CONN3.1 (GND), CONN4.1 (-), CONN5.2 (Ext), CONN6.0 (GND), CONN6.8, CONN6.17, CONN7.1 (GND__), CONN7.8 (GND__), CONN8.1, D3.1 (K), IC1.2 (GND), IC1.14 (GND), IC1.16 (GND), IC1.22 (GND), IC2.2 (GND), IC2.25 (EP), IC3.2 (GND), IC4.1 (VSS), IC4.5 (OT_PROG), IC4.9 (OK_HYST), IC4.10 (OK_PROG), IC4.12 (AVSS), IC4.13 (VSS), IC4.17 (EP), IC8.2 (A1), IC8.3 (A2), IC8.4 (GND), IC9.3 (A2), IC9.4 (GND), IC10.2 (A1), IC10.4 (GND), IC11.4 (GND), IC12.8 (GND), IC12.9 (GND), IC12.EP, Q4.1 (G), R1.2, R5.1, R6.1, R7.1, R11.1, R12.1, R15.2, R19.1, R21.1, SW1.2, SW1.4, SW2.C, SW2.EP
I2C2-SCL: CONN3.4 (SCL), CONN7.4 (SCL__), CONN7.5 (SCL__), IC1.5 (PB15), IC8.6 (SCL), IC9.6 (SCL), IC10.6 (SCL), IC11.6 (SCL), R10.2
I2C2-SDA: CONN3.3 (SDA), CONN7.3 (SDA__), CONN7.6 (SDA__), IC1.6 (PA15), IC8.5 (SDA), IC9.5 (SDA), IC10.5 (SDA), IC11.5 (SDA), R9.2
unnamed: CONN1.A5 (CC1), R7.2
unnamed: CONN1.B5 (CC2), R6.2
unnamed: C15.1, D1.1 (K), D3.2 (A)
unnamed: C15.2, D2.2 (A), L1.1, Q1.3 (D)
unnamed: IC4.16 (LBST), L2.2
unnamed: IC4.6 (VBAT_OV), R20.1, R21.2
unnamed: IC4.8 (VBAT_UV), R11.2, R14.1
unnamed: IC4.3 (VOC_SAMP), R2.1, R19.2
unnamed: IC4.7 (VRDIV), R14.2, R20.2
unnamed: C9.1, IC4.4 (VREF_SAMP)
unnamed: C10.1, C16.1, IC4.15 (VSTOR)
unnamed: IC12.10 (PROG), R5.2
PREVGH: C32.2, CONN6.21, D2.1 (K)
PREVGL: C33.2, CONN6.23, D1.2 (A)
RF: CONN5.1 (In), IC1.15 (RFIO)
RST: IC2.9 (~RST), R3.2
SPI2-MOSI: CONN6.14, IC1.27 (PA10)
SPI2-SCK: CONN6.13, IC1.24 (PB13~)
SWCLK: CONN8.3, IC1.4 (PA14), SW2.1
SWDIO: CONN8.4, IC1.3 (PA13), SW2.2
SWO: CONN8.6, IC1.8 (PB3), SW2.T
Solar+: C17.1, CONN4.2 (+), IC4.2 (VIN_DC), L2.1, R2.2
UART1-TX: CONN8.5, IC1.10 (PB6)
UART2-RX: IC1.18 (PA3), IC2.21 (TXD)
UART2-TX: IC1.19 (PA2), IC2.20 (RXD)
VBAT: CONN2.2 (+), Q4.3 (D)
VBUS: IC1.7 (PB4), IC2.8 (VBUS), R13.2, R15.1
VCOM: C37.2, CONN6.24
VDD: C34.2, CONN6.18
VDD-Display: C18.1, CONN6.15, CONN6.16, L1.2, Q2.3 (D), R23.1
VDD-Display-Charge: IC1.21 (PA9), R23.2
VDD-SENSORS-EEPROM: C5.1, C6.1, C7.1, C8.1, CONN3.2 (VCC), CONN7.2 (VDD__), CONN7.7 (VDD__), IC8.8 (VCC), IC9.2 (A1), IC9.8 (VCC), IC10.3 (A2), IC10.8 (VCC), IC11.2 (A1), IC11.3 (A2), IC11.8 (VCC), JP2.1 (A), Q3.3 (D), R8.1, R9.1, R10.1
VGH: C31.2, CONN6.5
VGL: C30.2, CONN6.4
VSH: C35.2, CONN6.20
VSL: C36.2, CONN6.22
~DISPLAY-CS: CONN6.12, IC1.11 (PB5)
~DISPLAY-RESET: CONN6.10, IC1.23 (PA0)
~Enable-3.3V-Switched-0: IC1.13 (PC0), Q2.1 (G), R17.1
~Enable-3.3V-Switched-1: IC1.12 (PC1), Q3.1 (G), R18.1
~MCU-RESET: C2.1, IC1.17 (RST), SW1.1, SW1.3
~WRITE-PROTECT: IC1.25 (PB9), IC8.7 (WP), IC9.7 (WP), IC10.7 (WP), IC11.7 (WP), R8.2

Notes on the sheet:
MCU LoRa-E5-LE-HF : STM32WLE5JC + SX126X
LiFePO4 Charger from 5V-USB
LiFePO4 Charger from Solar Panel
USB-C / UART
LiFePO4 Battery Charger
ePaper Display
EEPROM
Battery Charger (USB / Solar Cell)
External sensors

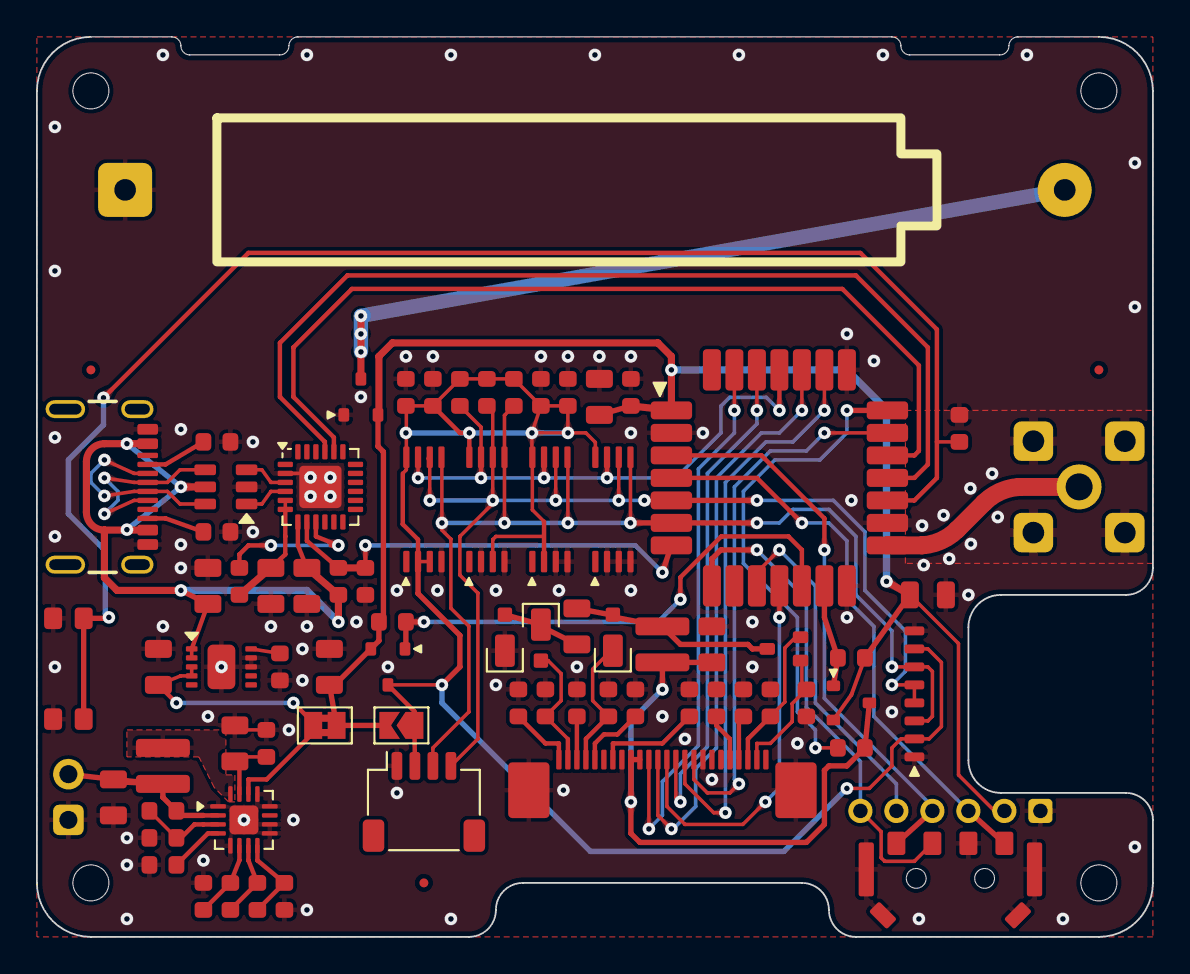
[picture p62: board LoRa-V3-PCB.kicad_pcb from above]

Board: 2 copper layers, 62.0 x 50.0 mm, 85 parts (1 on the bottom side), 57 nets.

Other parts of the board:
G01: CC-LOGO; CreativeCommonsLogo
