Strooom/LoRa-V3-PCB/(commit log)

2024-09-23 Add schematic in pdf format
    [LoRa-V3-PCB.kicad_sch]
2024-10-10 fix DRC error
    [73391-0080.stp, C0603.step, LoRa-E5-HF_3D_File.stp, LoRa-V3-PCB.kicad_pcb, LoRa-V3-PCB.kicad_sch, R0603.step]
2024-10-10 add workflow generated files
    [LoRa-V3-PCB-bom.csv]
2024-10-18 fix ERC warnings
    [LoRa-V3-PCB.kicad_pcb, LoRa-V3-PCB.kicad_sch]
2025-02-06 upgrade repo to new workflow
    expecting errors...
    [Bom-Mouser.csv, Lora-V3-Bom-Mouser.csv]
2025-02-06 bom fixes
    [LoRa-V3-PCB.kicad_sch]
2025-02-06 bom cleanup
    [LoRa-V3-PCB.kicad_sch, SOT23.STEP]
2025-02-06 fix bom
    removing extra fields
    [LoRa-V3-PCB.kicad_sch]
2025-02-06 fix footprints
    [LoRa-V3-PCB.kicad_pcb, LoRa-V3-PCB.kicad_sch, TSSOP8.STEP]
2025-02-06 outcommented blender render
    [LoRa-V3-PCB.kicad_pcb]
2025-02-06 improved camera
2025-02-06 fix lights
    [LoRa-V3-PCB.kicad_pcb]
2025-02-06 fix distance to PCB
2025-02-06 several fixes
    [LoRa-V3-PCB.kicad_pcb, LoRa-V3-PCB.kicad_sch, QFN24(4X4).STEP, SLLB510100.STEP, wurth-434331045822.stp]
2025-02-06 fix SHT40 footprint
    [LoRa-V3-PCB.kicad_pcb, LoRa-V3-PCB.kicad_sch, SHT40-AD1B-R2.step]
2025-02-18 finish solar power harvester
    [LoRa-V3-PCB.kicad_pcb, LoRa-V3-PCB.kicad_sch, MSMP package.STEP, QFN-16 (3x3).stp]
2025-02-20 improve solar layout
    [LoRa-V3-PCB.kicad_pcb, LoRa-V3-PCB.kicad_sch]
2025-02-24 reworked for 0805 capacitors
    [LoRa-V3-PCB.kicad_pcb, LoRa-V3-PCB.kicad_sch]
2025-02-24 fix missing 3D models
    [C0805.stp, LoRa-V3-PCB.kicad_pcb, LoRa-V3-PCB.kicad_sch, SON-06-FN_2000X2400_AMS.step]
2025-02-24 fix footprint for CP2102N
    [LoRa-V3-PCB.kicad_pcb, LoRa-V3-PCB.kicad_sch, QFN24-4X4.STEP]
2025-02-24 add permanent vdd for sensors with solder bridge
    [LoRa-V3-PCB.kicad_pcb, LoRa-V3-PCB.kicad_sch]
2025-02-24 fix missing datasheet on JP2
    [LoRa-V3-PCB.kicad_pcb, LoRa-V3-PCB.kicad_sch]
2025-02-24 fix JP2 metadata
    [LoRa-V3-PCB.kicad_sch]
2025-02-24 add extra csv file for kicost
    [LoRa-V3-PCB-bom.csv, LoRa-V3-PCB.kicad_pcb, LoRa-V3-PCB.kicad_sch]
2025-02-24 remove connectors from BOM
    [LoRa-V3-PCB.kicad_pcb, LoRa-V3-PCB.kicad_sch]
2025-03-11 add silkscreen logo version and date
    [LoRa-V3-PCB.kicad_pcb, LoRa-V3-PCB.kicad_sch]
2025-03-11 fix BOM
    [LoRa-V3-PCB.kicad_pcb, LoRa-V3-PCB.kicad_sch]
2025-03-11 fix BOM 2
    [LoRa-V3-PCB.kicad_pcb, LoRa-V3-PCB.kicad_sch]
2025-03-19 replace 5M36 resistor
    by a variant which is in stock
    [LoRa-V3-PCB.kicad_pcb, LoRa-V3-PCB.kicad_sch, kicost-bom.xlsx]
2025-03-19 fix metadata on L1
    [LoRa-V3-PCB.kicad_sch]
2025-03-19 update on USB ESD protection - partnumber
    [LoRa-V3-PCB.kicad_pcb, LoRa-V3-PCB.kicad_sch]
2025-03-19 cleanup bom on IC3
    [LoRa-V3-PCB.kicad_pcb, LoRa-V3-PCB.kicad_sch]
2025-04-16 final version with sensors on PCB
    [BC075-08-A-L-A.stp]
2025-04-17 routing complete
    [LoRa-V3-PCB.kicad_pcb, LoRa-V3-PCB.kicad_sch, LoRa-V3-Sensor-PCB-3D.step]
2025-04-17 cleaner routing
    [LoRa-V3-PCB.kicad_pcb]
2025-04-23 small routing improvements
    [LoRa-V3-PCB.kicad_pcb]
2025-04-23 repo cleanup
    [Back.step, Front.step]
2025-07-02 correct pins on sensor connector
    SDA and SCL were reversed
    [LoRa-V3-PCB.kicad_pcb, LoRa-V3-PCB.kicad_sch]
2025-08-07 layout improvements
    put solder bridges on front layer
    more gnd connectivity
    [LoRa-V3-PCB.kicad_pcb]
2025-08-07 replace battery holder
    to Keystone 2460
    [2460.step, LoRa-V3-PCB.kicad_pcb, LoRa-V3-PCB.kicad_sch]
2025-08-07 improve battery holder footprint
    [LoRa-V3-PCB.kicad_pcb]
2025-08-08 move SMA connector
    to board edge so more thread is available outside the enclosure
    [LoRa-V3-PCB.kicad_pcb]
2025-09-04 extend KiBOT with export of Gerbers
2025-09-04 fix gerber export with kibot
2025-09-04 fix kibot gerbers export
2025-09-04 testing gerber export
    [LoRa-V3-PCB.kicad_pcb]
2025-09-04 add drill export to kibot
2025-10-15 upgrade workflow
    [LoRa-V3-PCB-B_Adhesive.gbr, LoRa-V3-PCB-B_Courtyard.gbr, LoRa-V3-PCB-B_Fab.gbr, LoRa-V3-PCB-F_Adhesive.gbr, LoRa-V3-PCB-F_Courtyard.gbr, LoRa-V3-PCB-F_Fab.gbr, LoRa-V3-PCB-Margin.gbr, LoRa-V3-PCB-User_1.gbr]
2025-10-21 add gerber output to workflow
2025-10-27 layout improvements per review report
    [LoRa-V3-PCB.kicad_pcb]
