Strooom/LoRa-V3-PCB/(notices)

Notices in the files:
projectlibraries/inputs/PTS815SJM250SMTRLFS.stp:
author */ ('License CC BY-ND 4.0'),
README.md:
License: MIT
